Thorwegian/noaidi-fpga-synth/docs/adafruit_products_fab.png

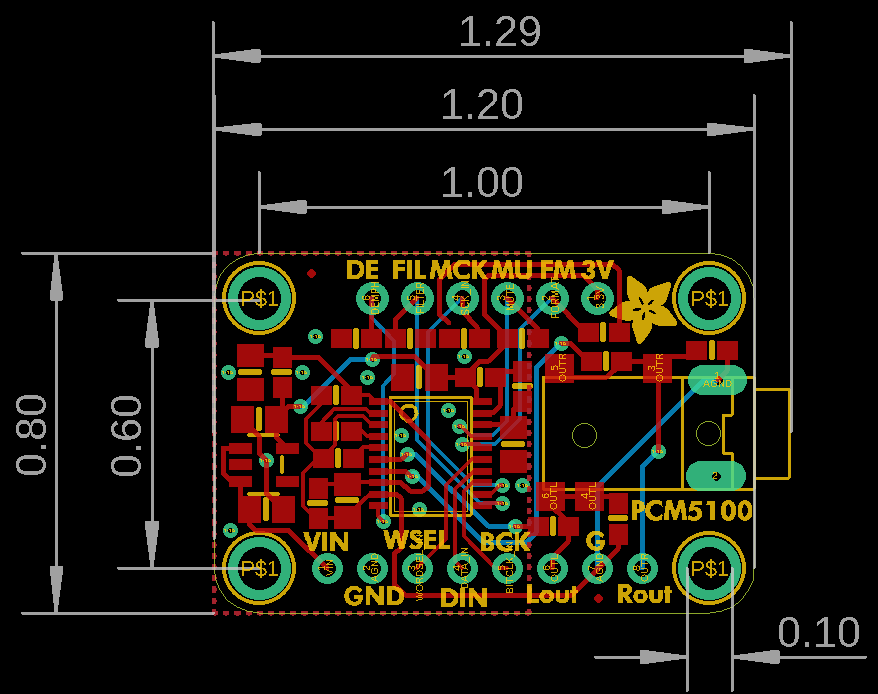
docs/adafruit_products_fab.png
