Thorwegian/noaidi-fpga-synth/docs/adafruit_products_schem.png

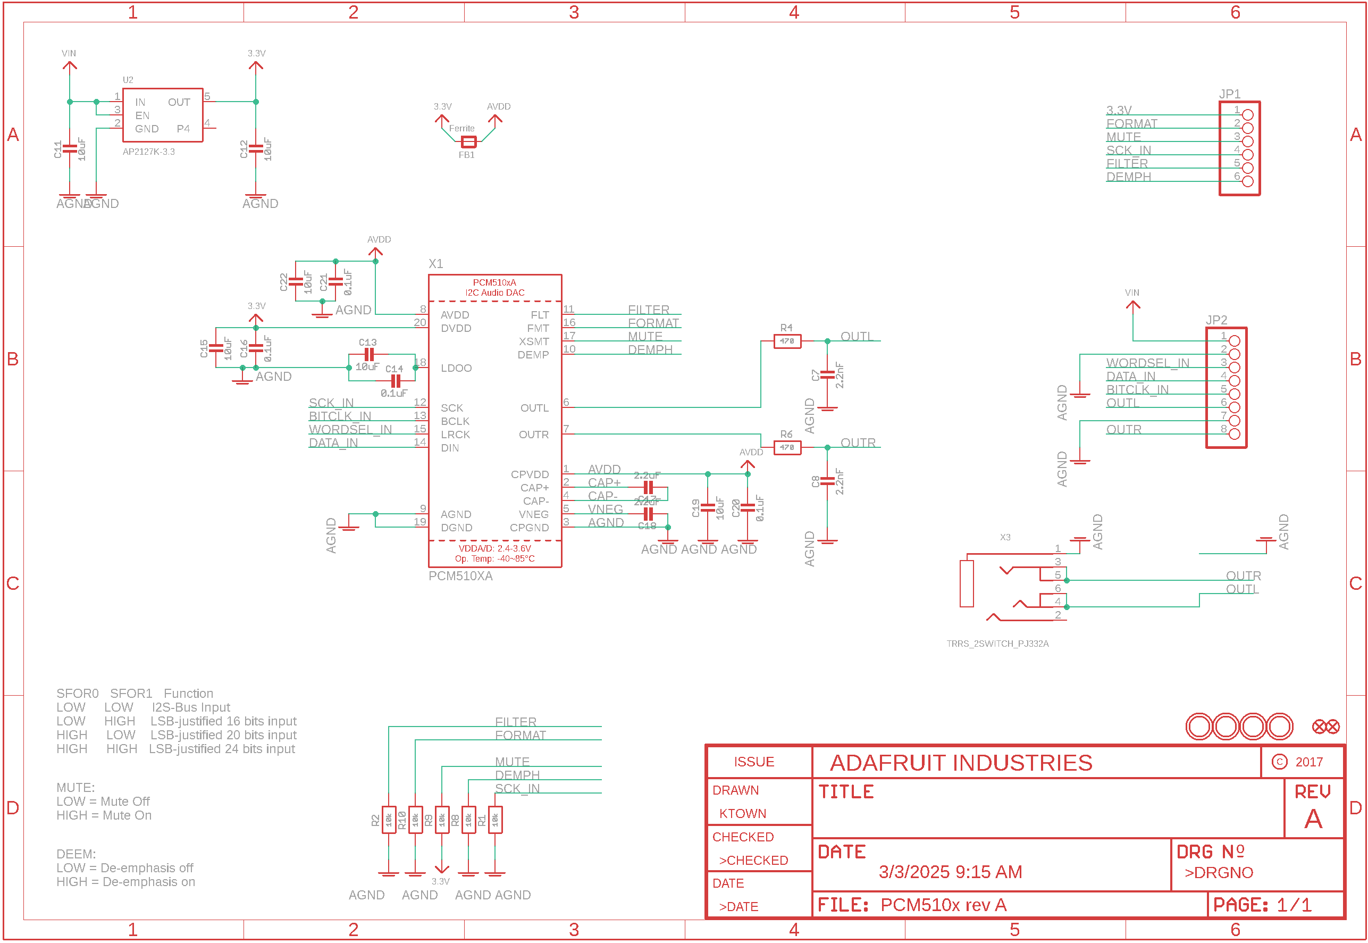
docs/adafruit_products_schem.png
