Thorwegian/noaidi-fpga-synth/docs/MIDI-circuit-6N138.png

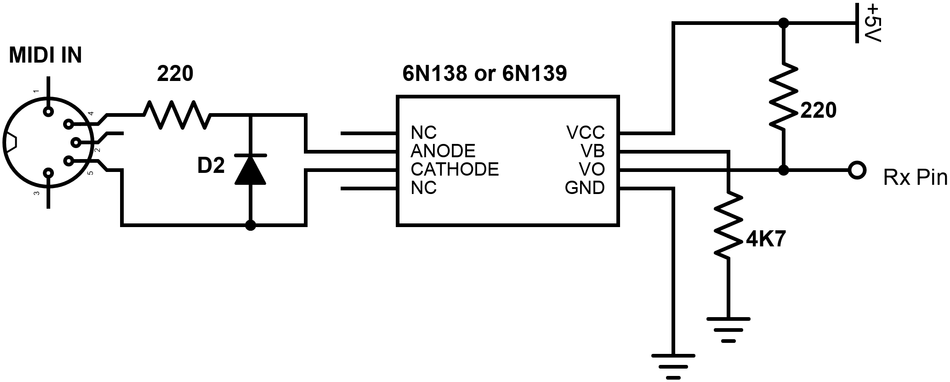
docs/MIDI-circuit-6N138.png
