Thorwegian/noaidi-fpga-synth/docs/Tang_Nano_20K_3921-Demensions.dxf

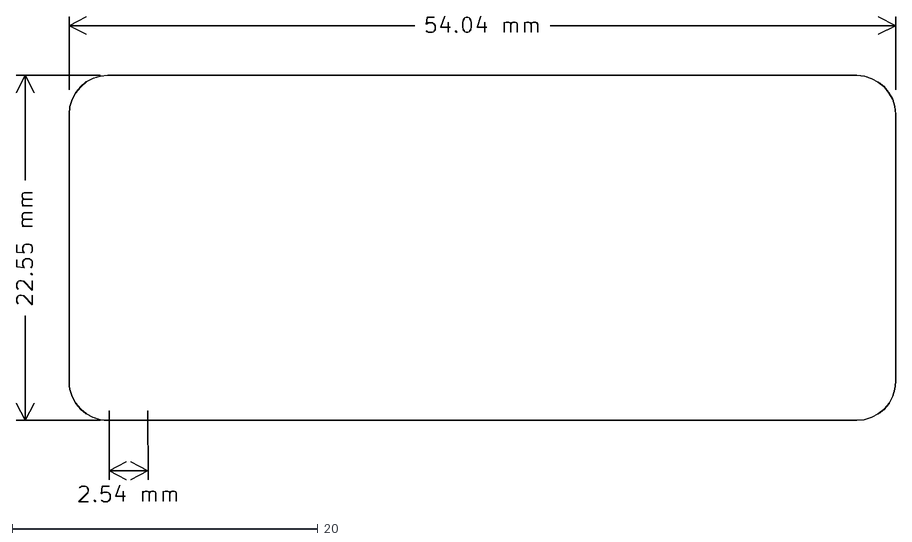
[picture p4: CAD file, 2026-09-15]
docs/Tang_Nano_20K_3921-Demensions.dxf
57.5 x 31.7
