Thorwegian/noaidi-fpga-synth/app/main/engine_link.c

// engine_link.c — command queue → parameter image → shadow writes → swap
//
// Copyright © 2026 Thor H. Linløkken <thj@thj.no>
// License: CERN-OHL-S v2

#include "engine_link.h"

#include <inttypes.h>
#include <string.h>

#include "esp_log.h"
#include "esp_rom_sys.h"
#include "esp_timer.h"
#include "freertos/FreeRTOS.h"
#include "freertos/queue.h"
#include "freertos/task.h"

#include "spi_regs.h"

#define TAG "engine_link"

#define ENGINE_QUEUE_LEN   1024   // voice_alloc's boot-time pointer
                                  // push alone is 512 commands
#define ENGINE_TASK_STACK  3072
#define ENGINE_TASK_PRIO   6          // above midi_log, below midi_in
// 1 kHz control rate (Thor). Paced by an esp_timer notifying the
// task, NOT vTaskDelayUntil: the FreeRTOS tick is 100 Hz, so a 1 ms
// delay would round to 0 ticks and assert.
#define ENGINE_TICK_US     1000

#define ELEM_BASE            0x2000
#define ELEM_STRIDE          64

// GAIN word with both channels at 0xFF = exact mute (0x00000000 is
// 0 dB full volume — the classic footgun).
#define P3_MUTE            0x0000FFFFu

static QueueHandle_t s_queue;
static QueueHandle_t s_bus_queue;
static uint32_t s_image[ENGINE_NUM_ELEMENTS][ENGINE_WORDS_PER_ELEMENT];

#define BUS_BASE_ADDR      0x0800
#define BUS_QUEUE_LEN      128    // init writes 32 envelope floors +
                                  // gates in one burst
#define PROD_BASE_ADDR     0x0100
#define PROD_QUEUE_LEN     512    // boot burst: 2 LFOs + 32 amp ADSRs
                                  // + 32 MOD envs (3 words each) + 32
                                  // fan-out sources (2 words) = 262
                                  // pushes before the 1 kHz tick can
                                  // drain. 256 silently dropped the
                                  // tail = voices 30/31's amp-env
                                  // configs = gain floor forever =
                                  // Thor's "every 32 note-ons it goes
                                  // low" (2026-09-10). Headroom 2x.

typedef struct {
    uint16_t bus;
    uint32_t value;
} bus_cmd_t;

typedef struct {
    uint8_t  entry;
    uint8_t  word;      // 0 CFG, 1 DEPTH
    uint32_t value;
} prod_cmd_t;

static QueueHandle_t s_prod_queue;
static uint32_t s_prod[ENGINE_NUM_PRODUCERS][3];
#define PDIRTY_WORDS (ENGINE_NUM_PRODUCERS * 3 / 32)
static uint32_t s_pdirty_now[PDIRTY_WORDS];
static uint32_t s_pdirty_prev[PDIRTY_WORDS];

// Dirty bitmaps, one bit per (elem, word): 1024 bits.
#define DIRTY_WORDS (ENGINE_NUM_ELEMENTS * ENGINE_WORDS_PER_ELEMENT / 32)
static uint32_t s_dirty_now[DIRTY_WORDS];   // changed since last swap
static uint32_t s_dirty_prev[DIRTY_WORDS];  // written before last swap

static uint32_t s_drops;

static inline void mark_dirty(int elem, int word)
{
    int bit = elem * ENGINE_WORDS_PER_ELEMENT + word;
    s_dirty_now[bit >> 5] |= 1u << (bit & 31);
}

// Write every image word to the current shadow bank. Boot-time only.
static void write_full_image(void)
{
    for (int e = 0; e < ENGINE_NUM_ELEMENTS; e++)
        fpga_word_write_burst(ELEM_BASE + e * ELEM_STRIDE, s_image[e],
                              ENGINE_WORDS_PER_ELEMENT);
}

static TaskHandle_t s_task;

static void tick_cb(void *arg)
{
    xTaskNotifyGive(s_task);   // runs in the esp_timer task
}

static void engine_task(void *arg)
{
    engine_cmd_t cmd;

    while (1) {
        ulTaskNotifyTake(pdTRUE, portMAX_DELAY);
        int64_t wake0 = esp_timer_get_time();

        // Live bus writes first: no banking, no swap — straight out.
        // No pacing needed: at 10 MHz one SPI word occupies the wire
        // for 5.6 us, longer than the mailbox's worst-case commit
        // wait (~3.6 us), so back-to-back writes cannot overrun the
        // 1-deep mailbox. (The stuck notes were a gateware
        // pending-clear bug, not an overrun.)
        bus_cmd_t bc;
        while (xQueueReceive(s_bus_queue, &bc, 0) == pdTRUE)
            fpga_word_write(BUS_BASE_ADDR + bc.bus, bc.value & 0x3FFFF);

        // Drain the queues into the images (elements + producers —
        // both banked, both covered by the same swap).
        bool changed = false;
        while (xQueueReceive(s_queue, &cmd, 0) == pdTRUE) {
            if (cmd.word >= ENGINE_WORDS_PER_ELEMENT)
                continue;   // elem is uint8_t: 0..255 by construction
            // No-op elision (Thor's Big-O/lazy principle, 2026-09-11):
            // the image IS the FPGA's state (the FPGA-reload → ESP-
            // reboot rule guarantees it), so a write of the value
            // already there is pure waste. voice_program re-renders
            // resend every word; skipping the unchanged ones turns a
            // one-knob re-render's flush from all 256 rows (~15 ms of
            // SPI — the wedge pressuring #97) into just the touched
            // rows.
            if (s_image[cmd.elem][cmd.word] == cmd.value)
                continue;
            s_image[cmd.elem][cmd.word] = cmd.value;
            mark_dirty(cmd.elem, cmd.word);
            changed = true;
        }
        prod_cmd_t pc;
        while (xQueueReceive(s_prod_queue, &pc, 0) == pdTRUE) {
            // entry is uint8_t = 0..255 — exactly the #100 pool, so
            // the old entry bound is vacuous (the type IS the bound)
            if (pc.word >= 3)
                continue;
            if (s_prod[pc.entry][pc.word] == pc.value)   // no-op elision
                continue;
            s_prod[pc.entry][pc.word] = pc.value;
            int bit = pc.entry * 3 + pc.word;
            s_pdirty_now[bit >> 5] |= 1u << (bit & 31);
            changed = true;
        }

        // Nothing new this tick and the shadow is already current
        // (nothing was written last tick either): skip write + swap.
        bool prev_any = false;
        for (int i = 0; i < DIRTY_WORDS; i++)
            if (s_dirty_prev[i]) { prev_any = true; break; }
        for (int i = 0; i < PDIRTY_WORDS; i++)
            if (s_pdirty_prev[i]) { prev_any = true; break; }
        if (!changed && !prev_any)
            continue;

        // Write dirty_now ∪ dirty_prev to the shadow, then swap. Burst
        // the WHOLE element row (7 consecutive words, one CS-framed
        // transaction) whenever any of its words changed. The ESP-IDF
        // SPI-master driver cost is per-TRANSACTION (bus lock, ISR,
        // semaphore), so the old per-word path turned a re-render into
        // hundreds of transactions and pinned this task until the
        // watchdog fired (#70). Untouched words in the row are already
        // current in s_image, so re-sending them is free.
        for (int e = 0; e < ENGINE_NUM_ELEMENTS; e++) {
            bool row_dirty = false;
            for (int w = 0; w < ENGINE_WORDS_PER_ELEMENT; w++) {
                int bit = e * ENGINE_WORDS_PER_ELEMENT + w;
                if ((s_dirty_now[bit >> 5] | s_dirty_prev[bit >> 5])
                        & (1u << (bit & 31))) {
                    row_dirty = true;
                    break;
                }
            }
            if (row_dirty)
                fpga_word_write_burst(ELEM_BASE + e * ELEM_STRIDE,
                                      s_image[e], ENGINE_WORDS_PER_ELEMENT);
        }
        for (int i = 0; i < PDIRTY_WORDS; i++) {
            uint32_t bits = s_pdirty_now[i] | s_pdirty_prev[i];
            while (bits) {
                int b = __builtin_ctz(bits);
                bits &= bits - 1;
                int idx = i * 32 + b;              // entry*3 + word
                fpga_word_write(PROD_BASE_ADDR + (idx / 3) * 4 + idx % 3,
                                s_prod[idx / 3][idx % 3]);
            }
        }
        fpga_swap();

        memcpy(s_dirty_prev, s_dirty_now, sizeof(s_dirty_prev));
        memset(s_dirty_now, 0, sizeof(s_dirty_now));
        memcpy(s_pdirty_prev, s_pdirty_now, sizeof(s_pdirty_prev));
        memset(s_pdirty_now, 0, sizeof(s_pdirty_now));

        // Drop visibility, always on (not just at init): a silent drop
        // is a voice configured wrong forever (2026-09-10, twice).
        static uint32_t s_drops_reported;
        if (s_drops != s_drops_reported) {
            ESP_LOGW(TAG, "engine writes dropped: %u total",
                     (unsigned)s_drops);
            s_drops_reported = s_drops;
        }

        if (s_drops) {
            ESP_LOGW(TAG, "queue full, dropped %" PRIu32 " commands", s_drops);
            s_drops = 0;
        }

        // Single-core guard (#70). If this wake ran long (a flood of
        // dirty rows to burst over SPI), the 1 kHz notify is already
        // pending, so the ulTaskNotifyTake above would return at once
        // and we would never block — starving IDLE (priority 0) on this
        // one-core chip → task watchdog. Yield a tick so IDLE runs; the
        // SPI image lags at most ~1 ms, which is inaudible.
        if (esp_timer_get_time() - wake0 > 800)
            vTaskDelay(1);
    }
}

void engine_link_init(void)
{
    // Image: every element gated off (and gain-muted for belt and
    // braces at boot), benign params otherwise. ALL pointers start on
    // bus 0 (the zero bus) — voice_alloc owns the plan and repoints
    // at note-on. (An earlier era parked cutoff pointers on bus 1 for
    // a hardwired wheel; the wheel rides BUS_CH_CUT since #44 and the
    // stale claim here was #110.)
    for (int e = 0; e < ENGINE_NUM_ELEMENTS; e++) {
        s_image[e][0] = 0;
        s_image[e][1] = 0;
        s_image[e][2] = 0x40000000;   // q1 = 1.0, fc = 0
        s_image[e][3] = P3_MUTE;
        s_image[e][4] = 0;            // GATE off
        s_image[e][5] = 0;            // PTRS0: all → bus 0 (none);
        s_image[e][6] = 0;            // PTRS1: voice_alloc owns the plan
    }

    // Both banks get the muted image before anything can play.
    write_full_image();
    fpga_swap();
    write_full_image();
    fpga_swap();
    ESP_LOGI(TAG, "both banks muted (%d elements)", ENGINE_NUM_ELEMENTS);

    s_queue = xQueueCreate(ENGINE_QUEUE_LEN, sizeof(engine_cmd_t));
    s_bus_queue = xQueueCreate(BUS_QUEUE_LEN, sizeof(bus_cmd_t));
    s_prod_queue = xQueueCreate(PROD_QUEUE_LEN, sizeof(prod_cmd_t));
    if (s_queue == NULL || s_bus_queue == NULL || s_prod_queue == NULL) {
        ESP_LOGE(TAG, "failed to create command queues");
        return;
    }

    if (xTaskCreate(engine_task, "engine_link", ENGINE_TASK_STACK, NULL,
                    ENGINE_TASK_PRIO, &s_task) != pdPASS) {
        ESP_LOGE(TAG, "failed to create task");
        return;
    }

    const esp_timer_create_args_t targs = {
        .callback = tick_cb, .name = "engine_tick",
    };
    esp_timer_handle_t timer;
    ESP_ERROR_CHECK(esp_timer_create(&targs, &timer));
    ESP_ERROR_CHECK(esp_timer_start_periodic(timer, ENGINE_TICK_US));
    ESP_LOGI(TAG, "1 kHz tick running");
}

bool engine_link_send(const engine_cmd_t *cmd)
{
    if (s_queue == NULL)
        return false;
    if (xQueueSend(s_queue, cmd, 0) != pdTRUE) {
        s_drops++;
        return false;
    }
    return true;
}

bool engine_link_bus_write(uint16_t bus, uint32_t value_q810)
{
    if (s_bus_queue == NULL || bus == 0 || bus >= 1024)
        return false;
    bus_cmd_t bc = {.bus = bus, .value = value_q810};
    if (xQueueSend(s_bus_queue, &bc, 0) != pdTRUE) {
        s_drops++;
        return false;
    }
    return true;
}

uint32_t engine_link_drops(void)
{
    return s_drops;
}

bool engine_link_prod_write(uint8_t entry, uint8_t word, uint32_t value)
{
    if (s_prod_queue == NULL || word >= 3)   // uint8_t entry spans the pool
        return false;
    prod_cmd_t pc = {.entry = entry, .word = word, .value = value};
    // Drops stay possible under a wedged flush (blocking here was
    // tried 2026-09-10 and reverted the same hour — risk containment
    // after a new symptom appeared with it live). The LOSSLESSNESS
    // guarantee lives one level up instead: voice_alloc's apply_dirty
    // checks engine_link_drops() around each config burst and RE-ARMS
    // the dirty bit when anything dropped, so the coalescer retries at
    // its own bounded pace until the config lands complete.
    if (xQueueSend(s_prod_queue, &pc, 0) != pdTRUE) {
        s_drops++;
        return false;
    }
    return true;
}
