Thorwegian/noaidi-fpga-synth/rtl/synth_pkg.sv

// synth_pkg.sv — shared design parameters
//
// Copyright © 2026 Thor H. Linløkken <thj@thj.no>
// License: CERN-OHL-S v2
//
// The single home for the design's constants (Thor: modules should
// not carry hardcoded numbers). Modules import what they need; module
// parameters default from here so testbenches can still override.

package synth_pkg;

    parameter int SAMPLE_RATE = 96000;
    // 768 x 96 kHz. Stepped down from 98.304 MHz (1024 slots) after
    // five ear-verified silicon timing failures that STA passed: the
    // fabric has no margin for our 36x36 DSP cascades at ~100 MHz,
    // and 25% more slack protects the paths we haven't found yet.
    parameter int SYS_CLK_HZ  = 73_728_000;

    //--- Drum (SCMO) scheduling -------------------------------------
    parameter int DRUM_CYCLES  = 768;    // SYS_CLK_HZ / SAMPLE_RATE
    parameter int DRUM_W       = 10;     // $clog2(DRUM_CYCLES)
    parameter int CELL_DIV     = 6;      // SPDIF cell = 6 sysclk (768 = 128 x 6)

    //--- Elements and lanes (design doc terminology) ----------------
    // The FPGA generates ELEMENTS (256 of them), technically via
    // LANES — time-multiplexed passes through the pipeline. The
    // ESP32 groups elements into voices; the FPGA never sees that.
    parameter int NUM_ELEMENTS = 256;
    parameter int ELEM_W       = 8;      // $clog2(NUM_ELEMENTS)
    parameter int UNISON       = 8;      // firmware convention only
    parameter int POLYPHONY    = 32;     // firmware convention only

    // Drum slot where element 0 enters the pipeline
    parameter int LANE_BASE    = 0;
    // Pipeline stages per element (S0..S11 + S3B/S5B/S8B/S9B splits)
    parameter int LANE_STAGES  = 16;
    // Contiguous drum span occupied by the lane pipeline
    parameter int LANE_SPAN    = NUM_ELEMENTS + LANE_STAGES - 1;

    // Drum slot where a pending ping-pong bank swap executes: the
    // pipeline is drained there (LANE_SPAN < SWAP_SLOT), so every
    // sample reads one consistent bank generation.
    parameter int SWAP_SLOT    = 512;

    //--- SPI memory map (docs/memory_map.md) ------------------------
    parameter int          MAP_AW_BACKED   = 11;       // 2048-word window
    parameter logic [7:0]  SPI_ID_BYTE     = 8'hA5;
    parameter logic [15:0] MAP_CTRL_ADDR   = 16'h0002; // bit 0: swap request
    parameter logic [15:0] MAP_ELEM_BASE   = 16'h2000; // per-element params
    parameter int          MAP_ELEM_STRIDE = 64;       // words per element

    //--- Bus fabric (docs/bus_architecture.md) ----------------------
    parameter logic [15:0] MAP_BUS_BASE = 16'h0800;    // bus base registers
    parameter int          DMEM_WORDS    = 512;         // uniform pool (#134)
    parameter int          BUS_W        = 18;          // signed Q8.10

    //--- Instruction table (B4/B5) -------------------------------------
    // 128 entries x 3 words, stride 4, at 0x0100-0x02FF. Config is
    // wiring, so it rides the ping-pong banks (law 4).
    //   +0 CFG:   [3:0] type (0 off, 1 LFO, 2 ADSR), [5:4] LFO shape
    //             (osc_core: saw/pulse/tri/sine), [15:6] target bus,
    //             LFO: [31:16] rate (low 16 bits of the UQ0.24 phase
    //                  increment — 5.7 mHz steps, 375 Hz max)
    //             ADSR: [25:16] gate bus (watched, level-sensitive:
    //                   value > 0 = held)
    //   +1 RATES (ADSR): [7:0] attack, [15:8] decay, [23:16] SUSTAIN
    //             (level fraction, 8 bits), [31:24] RELEASE — byte
    //             order matches patch_adsr_word(), the pipeline
    //             decode and memory_map.md (a swapped S/R in this
    //             comment was issue #105). Rates are 8-bit log2:
    //             increment = (16+frac) << oct on the 22-bit level
    //   +2 DEPTH: [17:0] signed Q8.10 contribution amplitude
    // A instruction's OUTPUT uses the previous sample's state (the
    // one-sample lag keeps every multiply's operands registered).
    // Pool 256, FULL RATE (#145): the CSP retires one instruction per
    // cycle, so all 256 entries execute every sample — 256 of the
    // sample's 768 cycles — and every source updates at 96 kHz. This
    // replaces the half-rate sequencer (#100, Thor 2026-09-11), which
    // walked alternate halves for 48 kHz effective because an
    // instruction then cost three cycles. Its allocator rule — a chain
    // (sources + their sends sharing a target) must live within ONE
    // half — is retired with it; a chain now tolerates gaps of up to
    // three slots, the depth of the accumulator's forwarding history.
    // Region 0x0100..0x04FF (stride 4). INSTR_PER_PASS is gone: a pass
    // is the whole table.
    parameter logic [15:0] MAP_IMEM_BASE = 16'h0100;
    parameter int          NUM_INSTR = 256;

    // CSP opcode = a bitmask of enables (#145), not an enum. Each bit turns
    // on one part of the datapath, so decode is enables rather than a mux
    // tree and a new instruction is an encoding rather than a new case.
    parameter int OPC_SOURCE = 0;   // reads a source operand (SEND, ADSR gate)
    parameter int OPC_STATE  = 1;   // has persistent state (LFO, ADSR)
    parameter int OPC_MUL    = 2;   // multiplies the operand by DEPTH
    parameter int OPC_ACCUM  = 3;   // accumulates onto the target, vs load init
    // An envelope is the instruction that watches a gate, so STATE+SOURCE
    // means envelope and STATE alone means phase accumulator -- no fifth bit
    // is needed and the opcode still fits CFG[3:0].
    parameter logic [3:0] OPC_OFF  = 4'h0;
    parameter logic [3:0] OPC_LFO  = 4'hE;  // state + mul + accum
    parameter logic [3:0] OPC_ADSR = 4'hF;  // source + state + mul + accum
    parameter logic [3:0] OPC_SEND = 4'hD;  // source + mul + accum

    //--- Filter stability clamp (Thor's call, 2026-08-31) ------------
    // Instability comes from HEAVY DAMPING (low Q = high q1), not
    // from resonance — theory and the autocorrelation bench agree.
    //
    //   FC_MAX = 0x2B20 = 14.4 kHz (Thor's pick): one measured-clean
    //   step of margin below the resonance bloom that precedes the
    //   16 kHz wall. Measured at q1 = sqrt(2), the heaviest damping
    //   any resonance code decodes to: clean through 15.7 kHz,
    //   limit-cycles at 16.4 kHz, chaos at 19.5 kHz.
    //
    // The old Q1_MAX = sqrt(2) clamp is retired (2026-09-02): with
    // log2-encoded resonance (r octaves of Q above Butterworth,
    // q1 = sqrt2 * 2^-r via q1_lut), r = 0 IS Butterworth and no
    // code decodes heavier — the clamp became structural. The high-Q
    // end stays open by design: at the top of the range the decode
    // underflows q1 to zero — self-oscillation as a feature.
    parameter logic [13:0] FC_MAX = 14'h2B20;

    //--- Number formats (design doc) ---------------------------------
    parameter int OSC_W = 24;       // UQ0.24 phase accumulator
    typedef logic signed [OSC_W-1:0] osc_t;

    parameter int CTRL_W = 14;      // UQ4.10 pitch/cutoff

    parameter int AUDIO_W = 18;     // Q4.14 audio transport (#63)
    typedef logic signed [AUDIO_W-1:0] sample_t;

    parameter int SVF_W = 36;       // Q8.28 filter states

    parameter int AUDIO_SHIFT = 14;

endpackage
