Thorwegian/noaidi-fpga-synth/app/main/patch.c

// patch.c — the active-patch instance and its default (issue #69).
//
// Copyright © 2026 Thor H. Linløkken <thj@thj.no>
// License: CERN-OHL-S v2
//
// Foundation of the VA surface: g_patch is the single source of
// truth for the active sound. patch_default() reproduces the former
// hardcoded timbre EXACTLY, so wiring voice_alloc to render from it
// is behavior-identical (verify: sounds the same). Later issues move
// more constants into the struct and add CC/SysEx mutation.

#include "patch.h"
#include <string.h>

patch_t g_patch;

// Pack an ADSR into the source-table RATES word (A | D<<8 | S<<16 |
// R<<24) — the gateware's universal A,D,S,R byte order.
//
// HALF-RATE COMPENSATION (#100): the walker advances each envelope
// every OTHER sample now (48 kHz effective), which alone would double
// every attack/decay/release time. The rate decode is
// (16+low4) << high4, so adding 1 to the exponent nibble (+0x10 on
// the byte) doubles the increment and restores wall-clock times
// exactly. Saturating: the 16 fastest codes flatten onto the ceiling
// (already sub-millisecond). Sustain is a LEVEL — untouched.
uint32_t patch_adsr_word(const adsr_t *e)
{
    uint32_t a = e->attack  > 0xEF ? 0xFF : (uint32_t)e->attack  + 0x10;
    uint32_t d = e->decay   > 0xEF ? 0xFF : (uint32_t)e->decay   + 0x10;
    uint32_t r = e->release > 0xEF ? 0xFF : (uint32_t)e->release + 0x10;
    return a | (d << 8) | ((uint32_t)e->sustain << 16) | (r << 24);
}

void patch_default(patch_t *p)
{
    memset(p, 0, sizeof(*p));

    // ---- oscillators (both rendered now, issue #72) ----
    // Default voice (Thor, 2026-09-08): the "7+1" structure — a
    // 7-voice supersaw (osc1) plus a single pure sine (osc2) one
    // octave below. The sine sub fattens the saws without muddying
    // the midrange; the ×7 detune gives the classic supersaw width.
    p->osc[0].wave   = WAVE_SAW;    // the ×7 supersaw
    p->osc[1].wave   = WAVE_SINE;   // the single "+1" — a pure sine
    p->osc[1].coarse = -12;         // one octave below the supersaw (sub)
    p->voice_struct  = VOICE_7_PLUS_1;
    p->osc_mix       = 0;      // centre balance
    p->unison_detune = 6;      // LSB per spread step (supersaw spread)
    p->unison_stereo = 127;    // full stereo spread = the historical
                               // hard pan (CC 28 continuous since #98)

    p->vel_amp_sens = 64;              // = historical (127-vel)>>1 feel
    p->vel_cut_sens = 64;              // = historical vel*48 brightening

    p->filter.key_track = 64;          // center = 100% tracking = the
                                       // historical voice_fc behavior
                                       // (#91; 0..200% scale since #94)
    p->filter.resonance = 0x200;       // was RESO (q1 = 1.0)
    p->filter.type      = 0;           // LP
    p->filter.dual      = 1;           // 24 dB/oct default (Thor, 2026-09-08)

    // amp env — was ADSR_RATES (0x98/0x20/0xF0/0x28, A,D,S,R)
    p->env[0].attack  = 0x98;
    p->env[0].decay   = 0x20;
    p->env[0].sustain = 0xF0;
    p->env[0].release = 0x28;

    // MOD env (#87, Thor 2026-09-09): ON by default in the boot patch —
    // same initial params as the AMP envelope, sent to the cutoff bus.
    // The filter contour tracks the loudness contour: opens with the
    // attack, settles bright at sustain, closes on release.
    p->env[1] = p->env[0];
    p->env1_dest      = 0;             // cutoff (the only dest yet)
    p->env1_depth     = 2048;          // +2 octaves send (CC 107 ≈ 96)

    // LFO 1 = the boot vibrato (source 0): 1 Hz triangle, ±19 cents
    p->lfo[0].shape = 2;               // triangle
    p->lfo[0].rate  = 350;             // ~1 Hz (increment per 48 kHz
                                       // walk since #100 — was 175
                                       // at the 96 kHz walk)
    p->lfo[0].depth = 16;

    // LFO 2 (#73, source 1): triangle, ~1 Hz, depth 0 = OFF; default
    // destination is PWM (duty bus) — the thing LFO 1 can't do.
    p->lfo[1].shape = 2;
    p->lfo[1].rate  = 350;             // ~1 Hz at the 48 kHz walk (#100)
    p->lfo[1].depth = 0;
    p->lfo[1].dest  = 0;               // 0 duty (PWM), 1 resonance.
                                       // (pitch is LFO 1's bus — one
                                       // producer per bus in the walker)

    p->volume     = 0xCF;              // was VOL_BASE (~-18 dB as volume)
    p->bend_range = 2;                 // current ±2 semitones
}
