Thorwegian/noaidi-fpga-synth/rtl/tb/tb_osc_core.sv

// Copyright © 2026 Thor H. Linløkken <thj@thj.no>
// License: CERN-OHL-S v2
//
//--------------------------------------------------------------------
// tb_osc_core.sv — oscillator waveform bench (was missing; issue #70
// ear reports: wave 3 "noisy tone", pulse duty "does nothing"). Drives
// a phase accumulator into osc_core the way the pipeline does
// (phase_next = phase + delta, now added in the bench since #128 moved
// that adder out of the module) and asserts the SHAPE of each waveform,
// plus that the pulse high-fraction tracks duty. Proves osc_core is
// functionally correct in isolation — so a hardware fault is upstream
// (bus/pointer plumbing or synthesis), not in the core math.
//--------------------------------------------------------------------
`default_nettype none
`timescale 1ns/1ps

module tb_osc_core;
    logic signed [23:0] phase, delta, duty;
    logic        [1:0]  wave;
    logic signed [17:0] sample_out;

    // #128 moved the phase adder OUT of osc_core (it was duplicated by
    // element_pipeline, and having it inside forced BSRAM read -> shift
    // -> add -> sine LUT -> mux into one cycle). The bench now performs
    // the same add the pipeline does, so every check below is unchanged:
    // phase_next is still phase + delta exactly as before.
    wire signed [23:0] phase_next = phase + delta;

    osc_core dut (
        .phase_next (phase_next), .duty (duty), .wave (wave),
        .sample_out (sample_out)
    );

    localparam int N = 64;                       // samples per cycle
    localparam signed [23:0] DELTA = 24'sh040000; // 2^24 / 64
    integer errors = 0;

    // Count how many of one cycle's samples are positive (high).
    task automatic high_count(input [1:0] w, input signed [23:0] d,
                              output integer hi);
        integer i;
        begin
            wave = w; duty = d; phase = 24'sd0; hi = 0;
            for (i = 0; i < N; i = i + 1) begin
                #1;
                if (sample_out > 0) hi = hi + 1;
                phase = phase + DELTA;
            end
        end
    endtask

    // One sample at an exact phase (delta 0 so phase_next == phase).
    task automatic sample_at(input [1:0] w, input signed [23:0] p,
                             output integer s);
        begin
            wave = w; duty = 24'sd0; delta = 24'sd0; phase = p;
            #1;
            s = sample_out;
            delta = DELTA;
        end
    endtask

    // Peak magnitude over one cycle.
    task automatic peak_mag(input [1:0] w, output integer pk);
        integer i, a;
        begin
            wave = w; duty = 24'sd0; phase = 24'sd0; pk = 0;
            for (i = 0; i < N; i = i + 1) begin
                #1;
                a = (sample_out < 0) ? -sample_out : sample_out;
                if (a > pk) pk = a;
                phase = phase + DELTA;
            end
        end
    endtask

    task check(input cond, input [255:0] msg);
        begin
            if (!cond) begin $display("FAIL: %0s", msg); errors = errors + 1; end
            else         $display("ok:   %0s", msg);
        end
    endtask

    integer h_lo, h_mid, h_hi, pk_saw, pk_sine;
    integer s_q0, s_q1, s_q2, s_q3;
    initial begin
        delta = DELTA;

        // SAW and the LUT SINE both reach near full-scale.
        peak_mag(2'd0, pk_saw);
        peak_mag(2'd3, pk_sine);
        check(pk_saw  > 30000, "saw reaches near full scale");
        check(pk_sine > 30000, "sine reaches near full scale (LUT)");

        // Sine cardinal points: 0 at phase 0, +peak at 1/4, 0 at 1/2,
        // -peak at 3/4 (a true sine, not the old parabola).
        sample_at(2'd3, 24'h000000, s_q0);
        sample_at(2'd3, 24'h400000, s_q1);
        sample_at(2'd3, 24'h800000, s_q2);
        sample_at(2'd3, 24'hC00000, s_q3);
        $display("sine cardinals: 0=%0d q=%0d h=%0d 3q=%0d", s_q0, s_q1, s_q2, s_q3);
        check(s_q0 > -600 && s_q0 < 600, "sine(0)   ~ 0");
        check(s_q1 > 30000,              "sine(1/4) ~ +peak");
        check(s_q2 > -600 && s_q2 < 600, "sine(1/2) ~ 0");
        check(s_q3 < -30000,             "sine(3/4) ~ -peak");

        // Pulse high-fraction must RISE with duty (the CC 25 sweep).
        high_count(2'd1, -24'sh600000, h_lo);
        high_count(2'd1,  24'sd0,      h_mid);
        high_count(2'd1,  24'sh600000, h_hi);
        $display("pulse high-count: lo=%0d mid=%0d hi=%0d (of %0d)", h_lo, h_mid, h_hi, N);
        check(h_lo < h_mid,  "pulse duty low  < mid  (width tracks duty)");
        check(h_mid < h_hi,  "pulse duty mid  < high (width tracks duty)");
        check(h_mid >= N/2-2 && h_mid <= N/2+2, "pulse at duty 0 is ~50%");

        // "ALL PASS" is the suite-wide success marker ci_bench.sh
        // greps for (this bench read "RESULT ...: PASS", which the
        // harness did not recognize once sim-osc joined CI in #107).
        if (errors == 0) $display("RESULT tb_osc_core: ALL PASS");
        else             $display("RESULT tb_osc_core: FAIL (%0d)", errors);
        $finish;
    end
endmodule
`default_nettype wire
