Thorwegian/noaidi-fpga-synth/app/main/midi_log.h

// midi_log.h — console monitor task for MIDI events
//
// Copyright © 2026 Thor H. Linløkken <thj@thj.no>
// License: CERN-OHL-S v2
//
// Subscribes to the event bus with its own queue and decodes/prints
// MIDI messages from its own task. This keeps blocking printf() out
// of the MIDI RX path.

#pragma once

#ifdef __cplusplus
extern "C" {
#endif

// Call once at boot (after event_bus_init).
void midi_log_init(void);

#ifdef __cplusplus
}
#endif
