Thorwegian/noaidi-fpga-synth/app/main/midi_parser.c

// midi_parser.c — MIDI byte-stream parser (pure, hardware-independent)
//
// Copyright © 2026 Thor H. Linløkken <thj@thj.no>
// License: CERN-OHL-S v2
//
// See midi_parser.h for the protocol behaviour. This module has no
// hardware dependencies and no heap usage — it can later be reused
// unchanged for other MIDI transports (USB MIDI, BLE MIDI, ...).

#include "midi_parser.h"

void midi_parser_init(midi_parser_t *p, midi_msg_cb_t cb, void *user)
{
    p->on_message = cb;
    p->user = user;
    midi_parser_reset(p);
}

void midi_parser_reset_partial(midi_parser_t *p)
{
    p->data_count = 0;
    p->in_sysex = false;
}

void midi_parser_reset(midi_parser_t *p)
{
    p->running_status = 0;
    p->data_count = 0;
    p->data_len = 0;
    p->in_sysex = false;
}

void midi_parser_feed(midi_parser_t *p, uint8_t byte)
{
    // ── System Real-Time (F8..FF) ──────────────────────────────────
    // May appear anywhere, including between the bytes of a running
    // message or inside SysEx. Ignored; never touch parser state.
    // FF (System Reset) additionally cancels Running Status.
    if (byte >= 0xF8) {
        if (byte == 0xFF) {
            p->running_status = 0;
            p->data_count = 0;
        }
        return;
    }

    // ── System Common (F0..F7) ─────────────────────────────────────
    // All of these cancel Running Status. SysEx payload is dropped
    // until the terminating F7.
    if (byte >= 0xF0) {
        if (byte == 0xF0) {
            p->in_sysex = true;
        } else if (byte == 0xF7) {
            p->in_sysex = false;
        }
        p->running_status = 0;
        p->data_count = 0;
        return;
    }

    // ── SysEx payload ──────────────────────────────────────────────
    if (p->in_sysex) {
        return; // drop everything until F7
    }
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
