Thorwegian/noaidi-fpga-synth/(commit log)

2026-07-06 feat: I2S clock generator + MS5351 pin constraints
2026-07-06 feat: wire I2S TX, SSPI-as-GPIO, audio path in top.v
2026-07-06 feat: voice pipeline — phase accumulator + naive sawtooth
2026-07-06 feat: NEORV32 firmware — UART1 MIDI + console commands
2026-07-06 docs: README with pinout, architecture, build flow
2026-07-06 docs: fix README — no PolyBLEP, MS5351 clock, 96 kHz, current status
2026-07-06 feat: Milestone 2 — bilinear SVF lowpass, 500 Hz Q=1.0, hw-verified
    - svf.sv: Lazzarini-Timoney bilinear SVF, combinational datapath
    - Q3.14 audio (18-bit), Q0.24 K (24-bit), all single-DSP multiplies
    - phase_accumulator: Q0.24, 24-bit, 440 Hz f_word=76896
    - osc_bank: full-scale saw, Q3.14 output
    - top.sv: SVF wired between osc and I2S
    - All .v files renamed to .sv
    - main.c: NEORV32 API fixes (getc, printf)
    - README: updated feature list, build commands
    - build.tcl: svf.sv enabled
    [i2s_tx.sv, main.c, top.sv]
2026-07-06 svf: working sweep with DSP-annotated bilinear SVF
    - svf.sv: bilinear SVF, Q3.14/Q0.24, 25-bit K_s padding, combinational
    path with DSP annotations on all 4 multiplies (7.5/24 DSPs used)
    - k_sweep.sv: LUT-based coefficient sweep module (320 entries, loops)
    - k_lut.hex: precomputed K/inv_res_K/inv_div table (18-18432 Hz, Q=6)
    - top.sv: wire k_sweep → SVF, K from LUT, coeffs from LUT
    - build.tcl: add k_sweep.sv, remove polyblep refs
    - README.md: remove polyblep refs
2026-07-07 feat: K LUT and coefficient computer modules
    k_lut.sv — 2560-entry K LUT with linear interpolation.
    256 entries/octave, 10 octaves (18 Hz – 18.4 kHz).
    Linear interp: 0.08 cents worst-case error.
    7.5 KB / ~4 BRAM blocks.
    coeff_computer.sv — top-level coefficient computer.
    Ties K LUT + DSP multiplies + denominator sum +
    NR reciprocal + inv_res_K adder together.
    ~12-cycle pipeline latency, ready for TDM integration.
    2 DSP multipliers for K² and K/Q.
    Related: #7 (TDM sequencer), #12 (coefficient engine)
2026-07-07 feat: combine K+K² in packed-struct LUT, remove k_sweep
    k_lut.sv now uses SystemVerilog packed struct:
    typedef struct packed {logic[17:0] K2; logic[23:0] K;} k_entry_t;
    2560 entries × 42 bits = 13.4 KB (~6 BRAM blocks).
    Precomputed K² saves 1 DSP per voice sample.
    coeff_computer.sv: reads K² from LUT instead of DSP compute.
    DSP count drops from 2 to 1 (K/Q only).
    Removed k_sweep.sv — replaced by coeff_computer pipeline.
    Verified: 120 vectors, 0 errors end-to-end in iverilog.
    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
2026-07-07 fix: anchor K LUT at MIDI D0 (note 14, 18.35 Hz)
    cent=0 → D0 (18.35 Hz), nearest musical note to 18 Hz.
    Maps cleanly: cents = (midi_note - 14) × 100.
    10.0 octaves, D0–D10 (MIDI 14–134, 18–18795 Hz).
    Also fixes gen_k_lut.py top-note display.
2026-07-07 docs: rewrite scripts with Java SDK-quality clarity
    gen_k_lut.py:
    - Structured: constants → LUT generation → verification → report
    - All constants named and documented with rationale
    - Clear variable names (frequency_hz, K_exact, entry_index)
    - Function docstrings explain what, why, and the RTL mapping
    coeff_computer_proto.py:
    - Full pipeline model: K LUT → DSP → NR reciprocal
    - 5 distinct tests with named sections
    - Consistent formatting, clear error metric explanation
    gen_nr_testvecs.py:
    - Merged functionality from gen_reciprocal_verify.py (removed)
    - Bit-exact RTL model with same LUT indexing as nr_reciprocal.sv
    All scripts verified: produce identical output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
2026-07-07 feat: wire coeff_computer into top.sv with 1-second sweep
    top.sv:
    - Replaced k_sweep with coeff_computer
    - Added 32-bit phase accumulator sweep: D0→D10 in ~1 sec
    - Sweep step = 1748 per sample (655360 units / 96000 samples)
    - SVF strobed by coeff_computer valid_out (not raw sample_strobe)
    - Q=6.0 hardcoded for testing (one_over_Q=2730)
    Stability verified in iverilog across D0–D10 (18 Hz – 18.8 kHz).
    Filter states stay bounded, no saturation at extremes.
    Related: #7 (TDM), #12 (coeff engine)
    [tb_svf_stability.sv, top.sv]
2026-07-07 refactor: gate NEORV32 with ifndef IVERILOG for iverilog testing
    top.sv now compiles standalone in iverilog (iverilog -DIVERILOG).
    NEORV32 is included for Gowin synthesis, stubbed for simulation.
    UART TX and LEDs get safe inactive values in test mode.
    Unblocks end-to-end iverilog testing of the full audio pipeline
    (clock → osc → coeff_computer → SVF → I2S).
2026-07-07 fix: drop sweep Q from 6 to 1 (filter saturating at high Q)
    Iverilog sweep simulation showed saturation at ±26k–±36k
    with Q=6 across the full frequency range. At Q=1, only
    marginal values within audio range (±15563, ±15923).
    The bilinear SVF with quantized coefficients is not stable
    at Q=6 across all K values. Q=1 matches the original sweep
    LUT setting.
    [top.sv]
2026-07-07 fix: AND sample_strobe with cc_valid for SVF timing
    cc_valid fires ~13 cycles after sample_strobe, which misaligns
    the DSP pipeline registers. SVF now gates on sample_strobe & cc_valid,
    keeping original I2S-synchronized timing.
    [top.sv]
2026-07-07 fix: use cc_valid rising-edge detect for SVF strobe
    sample_strobe & cc_valid never fires (both 1-cycle pulses at
    different times). Rising-edge detect on cc_valid gives a clean
    single-cycle strobe aligned with coefficient-ready.
    [top.sv]
2026-07-07 fix: reset sweep phase at end of range (was wrapping every 25.6s)
    32-bit accumulator wraps at 2^32/1748/96k = 25.6s. The actual
    sweep covers 1s, with 24.5s of saturation between wraps.
    Now resets at ~655200 cents (near end of 10-octave range).
    [top.sv]
2026-07-07 fix: revert SVF strobe to sample_strobe (pipeline has 1024 cycles headroom)
    [top.sv]
2026-07-07 feat: cross-instance Hermes status file for Mac ↔ Linux coordination
2026-07-07 feat: pulse oscillator, waveform mux in osc_bank
    osc_bank.sv now supports saw (000) and pulse (001).
    Pulse: phase < pwm_width → +1.0, else −1.0.
    pwm_width Q0.16, default 32768 = 50% duty.
    Fixed-point comparison matches Q0.24 phase format.
    Waveform mux: case statement, saw default.
    Ready for #1 pulse/triangle/supersaw waveforms.
    [top.sv]
2026-07-07 test: switch to pulse waveform for hardware test
2026-07-07 osc: triangle waveform from pulse integration
    - osc_bank.sv: triangle (010) — 27-bit signed integrator, pulse in, tri out
    - tb_osc_bank.sv: pass/fail testbench for saw/pulse/triangle
    - README.md: pulse marked done, triangle added to checklist
2026-07-09 osc: normalised triangle, Gowin fixes, sine implementation
    - osc_bank: freq_word port, normalised tri_step=sign(pulse)×freq_word
    (frequency-independent amplitude). Explicit tri_en latch to fix
    Gowin DFFE inference (strips single-cycle if(strobe) gate).
    - osc_bank: sine waveform (011), integrates triangle
    - top.sv: registered audio_sample to fix Gowin <<<4 bit-map
    mangling. WAVE_TRI/WAVE_SIN localparams. SVF bypass for debug.
    - Makefile: 'make silence' target for instant quiet
    - iverilog-verified: triangle at full scale across frequencies
    - Hardware-verified: triangle audible at 500 Hz
    [top.sv]
2026-07-09 repo: restructure to noaidi-fpga-synth root, extract neorv32
    - Move .git to noaidi-fpga-synth/ (repo name = git root)
    - Flatten rtl/rtl/ -> rtl/
    - Move sw/ and scripts/ to root level
    - Extract neorv32/ to /home/thor/Documents/Code/neorv32 (own repo)
    - Remove .hermes/ and HERMES_STATUS.md from repo
    - Fix .gitignore paths
    [top.sv]
2026-07-09 sine: in progress — Gowin synthesis bug in sin_acc path
    - Triangle: bipolar, normalised, hardware-verified at 1 kHz
    - Sine: simple integrator produces clean waveform in iverilog
    but silent/beeps in hardware (Gowin synthesis issue)
    - NEORV32 disabled, SVF disabled for faster osc dev cycle
    - Sine oscillator shelved for now — needs fresh debugging
    [top.sv]
2026-07-09 osc_bank: reset to blank slate — stateless phase-driven architecture
    Parallel waveform outputs (saw/pulse/triangle/sine), no internal state,
    no waveform select mux. Phase and duty are Q0.24 signed, allowing direct
    LFO modulation of pulse width. Implementation plan in osc_bank.md:
    saw=passthrough, pulse=comparator, triangle=abs()+shift, sine=¼-wave LUT.
    This is the architectural baseline — all previous self-oscillating
    integrator approaches are retired.
2026-07-09 osc_bank: stateless phase-driven implementation — hardware-verified
    osc_bank.sv — pure combinational waveforms:
    - Saw: phase passthrough
    - Pulse: signed comparator (phase < duty), verified at 0/33/50/66/100%
    - Triangle: fold at 2^23 midpoint, 2's-complement wrapping, no 25-bit
    - Sine: placeholder (zero)
    phase_accumulator.sv — standalone 24-bit Q0.24 accumulator, no reset
    top.sv — updated for new osc_bank parallel outputs (saw/pul/tri/sin),
    removed WAVE_* localparams, Q0.24 → I2S via >>> 4 (−24 dBFS)
    top_silence.sv + build_silence.tcl — minimal 'dead' bitstream,
    all outputs tied to idle, synthesises in ~10 seconds
    tb_osc_bank.sv — boundary verification: triangl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
    [top.sv]
2026-07-09 osc_bank: sine — ¼-wave LUT with quadrant decoding, hardware-verified
    4096×14-bit LUT covering [0, π/2]. Quadrant decode:
    phase[23:22] → quadrant, phase[21:10] → address
    Odd quadrants mirror address, Q2/Q3 negate output.
    Output: {raw, 10'd0} → Q0.24 signed, peak at 8191<<10.
    LUT generated by scripts/gen_sine_lut.py, stored as sine_lut.hex.
    Currently mapped to distributed RAM (3,475 LUTs) — BRAM inference
    to be forced later.
    All four waveforms now implemented and hardware-verified at 1 kHz
    on Tang Nano 20K: saw, pulse (0–100% duty), triangle, sine.
2026-07-09 SVF: re-verified with stateless osc_bank, Q=1 and Q=6 both stable
    Q0.24→Q3.14 conversion: $signed(osc_saw) >>> 9 (both saw and
    triangle are already bipolar — no centering needed).
    SVF output scaling: $signed({svf_out}) <<< 6 = −18 dBFS
    (matches working commit 3fd1b5f).
    Hardware-verified at 500 Hz, Q=1.0 and Q=6.0 on 440 Hz sawtooth:
    - Q=1: clean lowpass, no saturation
    - Q=6: strong resonant peak at cutoff, stable (±8k in Q3.14)
    - iverilog sim confirms both within ±16k bounds
    coeff_computer pipeline removed for now — timing issue between
    cc_valid and SVF strobe to be addressed separately.
    [top.sv]
2026-07-09 coeff_computer: removed — SVF verified stable at all K with static coeffs
    Oscillator bank + bilinear SVF hardware-verified on Tang Nano 20K:
    - Q=1: stable from 500 Hz to 18 kHz cutoff (static coefficients)
    - Q=6: stable at 500 Hz with resonant peak confirmed audible
    - All four osc waveforms (saw/pulse/tri/sine) working correctly
    coeff_computer pipeline removed — cc_valid strobe timing caused
    crackling at high K during sweeps. Individual modules (k_lut,
    nr_reciprocal, coeff_computer) passed iverilog but never reliably
    integrated with SVF in hardware.
    Deleted 12 files: coeff_computer pipeline modules, LUTs, testbenches,
    and Python generators. Future approach: precomputed BRAM LUT f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
    [tb_svf_stability.sv, top.sv]
2026-07-10 svf: remove superfluous clk — strobe directly as clock
    SVF state registers now clocked by @(posedge strobe) instead of
    @(posedge clk) with if(strobe) enable. strobe is a clean 96 kHz
    pulse — no need for a separate system clock in the filter.
    Filter datapath remains combinational. Coefficients (K, inv_res_K,
    inv_div) are still external ports — unchanged.
    Hardware-verified at 500 Hz Q=1.0 on Tang Nano 20K.
2026-07-10 svf: fix unsigned coefficient bug — wire signed on inv_res_K, inv_div
    inv_res_K and inv_div were declared unsigned (wire [17:0]),
    making all multiplies unsigned × signed = unsigned. This silently
    corrupted the product, wrapping 18-bit results and causing massive
    DC offset and gain error at high cutoff frequencies.
    Fix: wire signed [17:0] inv_res_K, inv_div. K stays unsigned
    (Q0.24 format is correct).
    Also: 160×8 LUT with 16/octave, 10-octave sweep, \u221a2/2\u201316 Q range.
    Sweep prescaled for ~1 second. Hardware-verified clean sweep
    across full range on Tang Nano 20K.
    [top.sv]
2026-07-11 tb_svf: fix Q0.24→Q3.14 shift (>>>6→>>>9) and use signed phase for bipolar sawtooth
    Testbench was feeding the SVF an 8× too-large unipolar sawtooth:
    - >>>6 instead of >>>9 (mismatched top.sv:148)
    - unsigned phase reg instead of signed
    This caused RTL output to saturate at ±130k Q3.14 (vs golden ±0.56).
    After fix: RTL range -0.44..+0.58 matches golden -0.56..+0.58.
    Remaining ~15% difference is expected Q3.14 quantization (see references/svf-golden-verification.md).
2026-07-13 Fixing Makefile, comments and misc details.
    [top.sv]
2026-07-13 rtl: add SPDIF transmitter module (IEC 60958, 96 kHz, 24-bit)
    Standalone biphase-mark encoded SPDIF output:
    - 98.304 MHz clk, /8 cell tick (12.288 MHz)
    - 96 kHz sample_strobe from I2S clock gen
    - M/W preambles, even parity, LSB-first
    - c_bit port for future channel status block
    - Verified in iverilog: all-zeros and 0xAAAAAA patterns
2026-07-13 rtl: integrate SPDIF transmitter into top level
    - Add spdif_out output port to top.sv (pin 27, LCD_B7)
    - Instantiate spdif_tx after I2S latch, fed from audio_sample
    - Mono for now: same signal on both L/R channels, c_bit tied low
    - Add pin constraint: LVCMOS33, DRIVE=8, PULL_MODE=UP
    - Add source file to build.tcl
    - iverilog: compiles clean, zero new warnings
2026-07-13 build: fix headless Gowin with xvfb-run
    QT_QPA_PLATFORM=offscreen fails on Qt/GLX (Gnome+Wayland).
    xvfb-run provides a virtual X server — Gowin works reliably.
2026-07-13 rtl: disable I2S output path, keep SPDIF only
    MAX98357A disconnected — SPDIF is now the primary audio monitor.
    I2S TX and data latch guarded behind .
    i2s_clock_gen stays (provides sample_strobe for voice pipeline + SPDIF).
    Ports driven to 0 when disabled (pa_en=0, amp safe).
    Re-enable: uncomment i2s_tx.sv in build.tcl, add -D ENABLE_I2S.
2026-07-13 docs: update README for SPDIF, I2S disable, retired coeff computer
    - Architecture: add SPDIF path, mark I2S disabled, remove coeff computer
    - Pinout: add spdif_out on pin 27
    - Directory: add spdif/, remove retired LUT/reciprocal/coeff files
    - Scripts: update to current gen_coeff_lut.py + gen_sine_lut.py
    - Status: SPDIF hardware-verified, coeff computer marked retired
2026-07-18 Add reference filter implementation in C
2026-07-18 Oscillator width in parameters package
    [params_pkg.sv]
2026-07-22 Fixed comments for filter.
2026-07-31 Added ESP32-C3 application processor
2026-07-31 Added SPI slave, signal name fixes, cleanup, new docs
    [spi_slave_regs.sv, top.sv]
2026-08-12 Basic SPI actually working; better supersaw test
2026-08-17 Cleanup, minor SPI stuff
2026-08-20 Add documentation of MIDI circuit
2026-08-20 rtl: SCMO 'drum' refactor — 256-voice sysclk pipeline
    - drum.sv: single timebase (1024 sysclk = 1 sample); sample_tick + voice_enter
    - voice_pipeline.sv: 12-stage SCMO pipeline x 256 voices (osc -> 2 SVFs ->
    log-gain stereo attenuation -> mix); state/param BSRAMs; DSPs inferred
    from plain multiplies
    - audio_clock.sv removed: i2s_tx is now a self-contained I2S master;
    spdif_tx consumes the drum tick and emits preamble cell 0 immediately on
    tick so frames stay contiguous and receivers lock
    - test patch (scripts/gen_test_patch.py): C-major chord across octaves,
    32 notes x 8 unison, hard-panned by unison index with inter-channel detune
    - gen_att_lut.py: attenuation log-gain decode LU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
2026-08-20 app: route MIDI messages through an event bus
    - event_bus.c/h: tiny pub/sub fan-out with per-subscriber drop counters;
    publishers never block on slow consumers
    - midi_log.c/h: console task subscribed to the bus, keeping printf out
    of the MIDI RX path
    - midi_in.c: parser callback publishes complete messages to the bus
    instead of printing
    - main.c: init bus and consumers before midi_in_init()
    - CMakeLists: add event_bus.c and midi_log.c
2026-08-21 rtl: register bank decoder layered on proven spi_slave (Step 1)
    Add reg_banks.sv — a dual-clock dual-port BSRAM register store driven by
    spi_slave's done/received_data handshake. Reuses the proven SPI
    transceiver unchanged; the BSRAM write port (sclk) and read port (sysclk)
    are the CDC. Command byte + data byte protocol, single-byte registers.
    Testbenches: tb_spi_basic (send 0xAA -> received_data==0xAA) and
    tb_reg_banks (end-to-end write + readback with isolation). make sim now
    runs sim-spi + sim-banks in addition to the existing pipeline/outputs.
2026-08-21 LED blink test: magic 0x55 in STATUS blinks LED + fix firmware CS framing
    FPGA (top.sv): led[0] blinks at sysclk/2^26 (~1.5 Hz) when STATUS[7:0]
    equals the magic value 0x55, confirming the full ESP32 -> SPI -> BSRAM ->
    FPGA loop on real hardware.
    Firmware (spi_regs.c): fix the burst-write misimplementation. The old
    code raised CS between command and data bytes (one fpga_xfer_byte per
    byte). Rewrite to send command+data in a SINGLE spi_device_transmit
    (native burst) so CS stays LOW across the whole frame, matching the
    FPGA's command/data framing. main.c now writes 0x55 to STATUS instead
    of the old echo test.
    [main.c, spi_regs.c, top.sv]
2026-08-21 Add SPI/BSRAM memory map.
2026-08-28 spi: fix both directions — give the slave a byte boundary
    The SPI link had one structural fault per direction, both from the same
    root cause: spi_slave tracked bits, not bytes, so it could neither commit
    a received byte nor load a byte to send at a byte boundary.
    TX (the observed symptom — "one constant byte works, anything else
    returns 0x00"): shift_out was loaded only on the CS rising edge, i.e. at
    the end of the *previous* transaction, then shifted left with zero fill.
    Byte 0 carried the stale constant and read correct; every later byte was
    structurally 0x00. A value computed during the transaction (mem[addr], a
    loopback of the received byte) had no load path at all.
    RX: spi_slave r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
    [main.c, spi_regs.c, spi_regs.h, spi_slave_regs.sv, tb_spi_slave_regs.sv, top.sv]
2026-08-28 spi: declare power-up state; fix testbench string arg
    Two fixes found by running the real toolchain (iverilog 12.0 + yosys
    0.67 on thj.no), neither of which the hand model could have caught.
    1. spi_slave_regs.sv — every reset in the module is `posedge cs`, and at
    power-up CS is already high: it goes 1->0 for the first transaction,
    so that edge never occurs and nothing is reset before the first frame.
    Gowin FFs leave configuration at 0 so hardware would have been fine,
    but the state was never declared, so a simulator starts them at X and
    the entire first transaction decodes to garbage. The bench caught it
    precisely: tests 2 and 3 (the first write, and reading it back) fai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
    [spi_slave_regs.sv, tb_spi_slave_regs.sv]
2026-08-28 docs: record measured SPI link speed — clean to 40 MHz
    Verified on hardware (thor-mini-linux + Tang Nano 20K + ESP32-C3), with
    the new spi_slave_regs bitstream loaded into FPGA SRAM:
    11 rates from 1 MHz to 40 MHz, 8 repetitions each. Every repetition
    wrote four registers, burst-read them back and checked the ID byte
    plus all four values. 88/88 correct, no degradation at any rate.
    40 MHz is the ESP32-C3's ceiling for SPI2 through the GPIO matrix (the
    configured pins are not the IOMUX ones) — the link never failed, the
    master ran out. nextpnr closes the u_spi.sclk domain at 230-269 MHz, so
    the slave was never the constraint.
    This settles an open question in the memory map, which p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
2026-08-28 docs: settle the dual-clock BSRAM CDC question — it works
    Decision 7 carried a risk note: "if yosys cannot infer dual-clock BSRAM,
    fall back to an inbox/commit design." Nobody had tested it, and the whole
    CDC stance for the 64K map rests on it. Tested now, on the real toolchain
    (yosys 0.67 / nextpnr-himbaechel / gowin_pack, GW2AR-LV18QN88C8/I7):
    semi dual-port, 2 clocks, 2048x36 -> 4x DPX9B, packs, builds
    same + ping-pong bank-select in addr -> 4x DPX9B, unaffected
    true dual-port, both ports read+write -> ERROR: no valid mapping
    256x36 -> 0 blocks (LUT-RAM chosen)
    Place-and-route on the real part: BSRAM 4/46, clock domains closing at
    549 MHz an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
    [spi_slave_regs.sv]
2026-08-28 docs: correct the BSRAM claim — it builds, it is not verified
    The previous commit said the dual-clock BSRAM CDC question was
    "resolved" and decision 7's fallback was "not needed". That over-claimed,
    and the challenge was fair. Correcting it.
    What was actually established: yosys infers dual-clock BSRAM, nextpnr
    packs it (BSRAM 4/46), gowin_pack emits a bitstream, and a netlist audit
    shows CLKA and CLKB on genuinely distinct nets with write-enable only on
    the A port. The structure is right.
    What was NOT established: that any of it behaves correctly. And in this
    flow it cannot be, because every Gowin BSRAM primitive in oss-cad-suite
    (SP, SPX9, SDPB, SDPX9B, DPB, DPX9B, pROM) is a blackbox i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
2026-08-28 spi: add read-only STATUS window so the FPGA can report its own state
    Adds the fabric -> host read path the memory map specifies at 0x001
    STATUS, which until now did not exist in any form: the register store
    could only ever return what the host had previously written to it.
    Addresses RO_BASE..NWORDS-1 read a byte of a new `status_in` port instead
    of the RAM. RO_BASE defaults to NWORDS, so with no parameter override the
    whole read-only path is a compile-time constant false and the module
    behaves exactly as before — the existing tests are unaffected.
    CDC: status_in changes continuously in the sysclk domain, so sampling it
    byte-by-byte from the sclk side would tear a multi-byte value across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
2026-08-28 spdif: block sync + channel status — what a receiver actually requires
    B preamble every 192 frames and a valid channel status block (consumer
    PCM, 96 kHz byte3=0x0A, 24-bit byte4=0x0B). The old c_bit=0 tie declared
    44.1 kHz for a 96 kHz stream; PREAMBLE_B existed only as a comment. A
    pro interface frames channel status off the B preamble, so without one
    it never reports lock.
    The fixed-polarity preamble trick is now documented where it lives: even
    parity guarantees the line returns low before every preamble.
    tb_spdif_block.sv decodes two full 192-frame blocks: preamble cadence
    (B/M/W), biphase parity, payload integrity, and the assembled CS bytes.
    Also removes two stale testbenches that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
    [spdif_tx.sv, tb_outputs.sv, tb_spdif_block.sv]
2026-08-28 spdif-minimal: drum + spdif alone, clocked from the 27 MHz crystal
    The smallest thing that can put a valid SPDIF stream on the coax: rPLL
    multiplies the always-present 27 MHz crystal (pkg pin 4) by 11/3 to
    99.0 MHz, the drum divides by 1024, a 1.5 kHz square at -18 dBFS feeds
    spdif_tx. Fs = 96.68 kHz; receivers lock to the actual bit rate, so
    this works on a board whose MS5351 was never configured.
    The SPI counter instrument stays in so the PLL rate is measured over
    SPI, not assumed. led[5] = PLL lock.
2026-08-28 tb_spdif_block: decode every frame, not every other one
    The frame-complete check wrote ci in the same cycle as the next
    sample_tick reset; the later non-blocking write won, ci stuck at 129,
    and the bench skipped alternate frames. All block-start frames fell in
    the skipped half, so it reported B missing from a stream that carried
    it, and assembled channel status from the odd-indexed bits (the observed
    {12,13,16,17} = bits {25,27,33,35} of the real block, halved).
    Same lesson as tb_reg_banks: when a bench fails, decode WHICH wrong
    answer it produced before trusting it over the DUT.
    [tb_spdif_block.sv]
2026-08-28 tb_spdif_block: release reset off the clock edge
    Blocking rst_n release at a posedge races the DUT always blocks: the DUT
    starts frame 0 on that edge, the bench misses the first sample_tick and
    labels every frame one late -- B missing at 192k and channel status
    read as CS_FLAT[f+1]. Release on the falling edge so DUT and bench see
    the same first tick.
    [tb_spdif_block.sv]
2026-08-28 tb_spdif_block: print frame-1 cells for A/B against the 052d920 stream
    Frame 1 is an ordinary M-frame with CS bit 0, so it must be
    bit-identical to what the confirmed-working 052d920 build emitted.
2026-08-28 spdif-minimal: mirror the stream on pkg pin 56
    Every bitstream loaded on the new board before the PLL fix had a dead
    sysclk, so pin 27 has never been observed toggling on this board. The
    mirror gives a second probe point: signal on 56 but not 27 = pin 27
    path; neither = deeper; lock via a jumper from 56 = pin 27 damaged.
    [top.sv]
2026-08-28 docs: SPDIF debug toolkit — A/B result, in-fabric cell snapshots
    The drum-based stream is bit-identical to the audio_clock-era stream
    confirmed working on hardware. The FPGA can verify its own output: 64
    live cells snapshotted into the SPI STATUS window per CS assert, decoded
    by the run-of-3 rule (biphase data never has one; preambles always do).
    Measured on hardware: 14/16 snapshots valid IEC 60958, 2 edge-truncated.
2026-08-28 spdif: exact 96.000 kHz via fractional cell DDS
    The Focusrite detects the stream but refuses lock and falls back to
    44.1 kHz — the signature of rate-window validation, and our crystal-PLL
    stream runs +0.7% high (96,688 Hz). Exact rate needs exactly 98.304 MHz,
    which 27 MHz cannot reach: 98.304/27 = 4096/1125, and no in-spec rPLL
    ratio (single or cascaded — PFD floor kills every factorization of
    1125) produces it.
    So the cell timebase goes fractional: spdif_tx now takes cell_tick as
    an input, and the top feeds it from an accumulator (+512 mod 4125 per
    99 MHz cycle) whose average is 12.288000 MHz exactly. 128 cells per
    frame gives Fs = 96,000.000 Hz to the crystal's ppm. Cells are 8 or 9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
2026-08-28 spdif: cell_dds module + jitter-aware end-to-end testbench
    The fractional timebase was living only in top.sv, unsimulated — the
    exact place an off-by-one makes 127/129-cell frames that average to
    128.000 and pass a rate measurement while a receiver rejects every
    frame. It is now its own module, so the same source is verified by
    tb_spdif_dds.sv and synthesized by top.sv.
    The bench checks what the uniform-cell bench cannot: every frame is
    exactly 128 cells under 8-or-9-cycle jittered cells, cell lengths are
    only ever 8 or 9 with the 4125/512 average, plus the usual preamble
    cadence / parity / payload / channel status.
    CMakeLists gains esp_timer so rate measurements are microsecond-grade
    (c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
    [top.sv]
2026-08-29 docs: SPDIF audible on hardware; correct the serial-port map
    Sound confirmed on the Focusrite via the fractional-DDS exact-96k
    stream (distortion noted, unresolved). ttyUSB1 is the FPGA UART bridge
    and is rightly silent when the bitstream has no UART; earlier notes
    misread that as a BL616 fault. No debugger reflash was needed.
2026-08-29 mainline return: 256 voices -> SPDIF on the real 98.304 MHz clock
    The MS5351 on this board is configured (pll_clk O0=98.304M -s, done at
    the bench 2026-08-29), so pin 10 carries the real sysclk again and the
    workaround stack retires: no rPLL, no fractional cells. The drum
    free-runs /1024 -> exactly 96.000 kHz with uniform /8 cells, the
    256-voice pipeline reconnects unchanged, and spdif_tx keeps the branch
    fixes (B preamble, channel status) via its cell_tick port.
    cell_dds stays in the tree as the documented crystal-only fallback but
    is out of the build. I2S remains disconnected pending confirmation of
    what is wired to pins 54-56. STATUS window now reports sysclk and
    sample-tick counters so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
    [top.sv]
2026-08-29 rtl: drum owns the cell tick; top.sv back to pure composition
    'drum.sv is the sole timebase' made literal: the SPDIF cell boundary is
    a decode of the slot counter the drum already owns (slot[2:0]==0, so
    1024 = 128 cells x 8 and alignment with sample_tick holds by
    construction, not by convention between separate counters).
    top.sv sheds everything that had accreted onto it -- the local cell
    divider, edge counters, diagnostic STATUS plumbing -- and is composition
    again: drum, pipeline, spdif, spi, one liveness LED. The instrumented
    diagnostic tops live in this branch's history when needed.
2026-08-29 rtl: reconnect I2S — same veroboard, same pinout
    Confirmed the new Tang sits in the same veroboard slot with unchanged
    wiring, so pins 54-56 carry I2S exactly as before. i2s_tx returns to the
    build and to top.sv in its mainline form (self-clocked master, BCLK =
    sysclk/16, latches on the drum's sample_tick), and tb_outputs — which
    decodes the SPDIF cell stream AND checks the I2S clock rates — rejoins
    `make sim`.
2026-08-29 spi: memory-map wire protocol — spi_bus.sv + firmware word API
    The docs/memory_map.md transaction format, implemented: command byte
    ([7] R/W, [6] auto-increment) + 16-bit address + streaming 32-bit data
    words, MSB first (byte-order choice documented; not specified in the
    map). Wire format is decoupled from storage geometry: the protocol
    speaks the full 16-bit space while an 11-bit window (2048 x 36-bit
    dual-clock BSRAM) backs it. Out-of-window writes are dropped and reads
    return zero -- no aliasing.
    Reads carry a 2-byte turnaround after the address: the store's read
    port is in the sysclk domain (true dual-port BSRAM does not map --
    measured), a fetch costs ~60 ns, and the first data byte'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
2026-08-29 spi_bus: latch the outgoing word per word boundary
    The TX mux read resp live, so the next-word prefetch (or a single-word
    frame prefetching its empty neighbor) overwrote it mid-word and clipped
    the tail bytes -- all 13 bench failures, one cause. tx_word latches at
    each word boundary in the sclk domain; resp is then free to change
    under later prefetches.
    [spi_bus.sv]
2026-08-29 svf: give the states their headroom -- fixes noise below ~14 kHz cutoff
    Reported from the bench: any cutoff below 0x2AF8 (~14 kHz) produced
    noise; the filter only worked wide open, including with FC = pitch for
    key tracking.
    Cause: audio entered the filter as osc <<< 18 -- Q2.16 landing 64x hot
    in the Q8.28 state format, using up the 8 integer bits the design doc
    reserves as overshoot headroom. Wide open, hp stays tiny and nothing
    overflows; with the cutoff below the input's energy, hp = in - lp - q*bp
    sums three near-full-scale terms, wraps the 36-bit state, and the wrap
    feeds back through ic1/ic2 -- sustained noise. The K decode itself is
    correct (verified numerically across octaves); the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
    [voice_pipeline.sv]
2026-08-29 svf: split adder trees from multiplies -- fixes the silicon crackle
    Bench experiment, definitive: with fc=0x1000 the same bitstream crackles
    ("rain on a metal roof") at 98.304 MHz and is smooth at 49.152 MHz, and
    the same RTL + hexes render glassy smooth in simulation (max sample step
    -52 dBFS, verified by ear on rendered WAVs). Identical computation,
    double deadline, no crackle: a data-dependent setup violation, on the
    stage that chained three 36-bit adds straight into the 36x36 DSP
    multiply (S5/S8: hp = in - lp - q*bp feeding K*hp in one cycle).
    Low-cutoff operation parks the states near full scale creeping by small
    increments -- exactly the operand pattern that fires full-length carry
    rip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
    [voice_pipeline.sv]
2026-08-29 svf: S6 was a chimera -- half its inputs read one stage too early
    The S5B insertion left S6 consuming a mix of s5b_* (m3, ic1eq1, ftype)
    and s5_* (lp1, hp1, everything else): voice v's multiply combined with
    voice v+1's adder outputs. Cross-voice state corruption pumped energy
    into the filters -- the avalanche heard on the bench, clock-invariant
    because it is pure logic. Reproduced in sim (peak growing 2.5M -> 7.4M
    by sample 4000) before fixing; the bulk edit that converted S6 had
    silently failed on two of three blocks and a reference count gave false
    confidence. All S6 inputs now come from S5B; a stage-skip audit shows
    zero s5_/s8_ references beyond their following stage.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
    [voice_pipeline.sv]
2026-08-29 svf/att: register the gain decode before the stereo multiply (S9B)
    Half-clock A/B from the bench: right channel heavily distorted at
    98.304 MHz, both channels clean at 49.152 MHz -- another data-dependent
    setup violation, and the channel asymmetry localizes it: voices are
    shared hardware, the channels only diverge in the attenuation stage,
    where each channel chained att_lut read + 16-position barrel shift into
    an 18x18 multiply in one cycle. Two structurally identical paths; the
    right drew the longer route on this build.
    S9B registers the decoded gains; S10 multiplies registered operands.
    Depth 14 -> 15, span 270 slots, writeback spacing 14 -- collision-free.
    Known same-class residual, del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
    [voice_pipeline.sv]
2026-08-29 tb_voice_pipeline: atten cross-check tracks the S9B latency
    The check assumed s10 is driven by the previous cycle s9 values; with
    the S9B decode stage between them it is two cycles. The latency-agnostic
    mixer check passing throughout confirmed the datapath values were right;
    only the bench model was stale.
2026-08-29 docs: verified — working filter and clean SPDIF on hardware
    Bench-confirmed by ear at full SYSCLK and at SYSCLK/2: the low-cutoff
    patch (fc=0x1000) plays a clean muffled chord on both channels through
    SPDIF after the S5B/S8B/S9B timing splits. ESP32 SPI test re-run: still
    OK/PASS. AGENTS.md now carries the silicon timing rule (decode/adds-only
    or multiply-only per stage) and the diagnosis method that found it:
    sim-vs-silicon A/B plus the reversible half-clock listen.
2026-08-29 docs: pipeline notes updated to the 15-stage reality
2026-08-29 control plane: integration flip to the memory-map wire protocol
    top.sv swaps the byte-protocol bring-up slave for spi_bus (16-bit word
    addresses, 32-bit data, 11-bit backed global window), and main.c
    replaces the byte self-test with a word-protocol one mirroring
    tb_spi_bus.sv cases: single write/read, burst auto-increment, and the
    out-of-window drop/zero/no-alias contract. spi_slave_regs.sv stays in
    the tree as reference with its bench still in `make sim`.
    First rung of the GATE ladder (gate before ADSR, per bench decision):
    the control plane must be live and verified before the first writable
    per-voice register exists.
    [main.c, top.sv]
2026-08-29 tb: voice bench owns its patch -- committed reference fixtures
    tb_voice_pipeline compared the DUT against expectations built for the
    committed open-filter patch while the DUT read whatever hexes the tree
    held -- so any bench-side experiment in scripts/gen_test_patch.py made
    the suite cry wolf (it did, twice). The patch ROM paths are now module
    parameters; the bench overrides them (DUT and its model both) with
    rtl/tb/ref_patch_*.hex, committed fixtures generated from the committed
    script. Synthesis keeps the tree hexes via the defaults.
    [tb_voice_pipeline.sv, voice_pipeline.sv]
2026-08-29 per-voice parameters writable over SPI; single voice programmable
    spi_bus decodes the memory map's per-voice range (0x2000 + v*64,
    offsets 0..3 = OSC/DUTY/FILTER/GAIN) into a combinational write port,
    valid on the same sclk edge that completes a data word (a master may
    never clock again after the last bit -- the lesson spi_bram taught).
    The param RAMs in voice_pipeline grow an sclk write port; their reads
    become synchronous on sysclk (same timing as the old comb-read+register,
    but the shape yosys infers as dual-clock BSRAM -- the BSRAM is the CDC,
    per the design doc). Hex init remains the boot patch.
    tb_voice_program drives the whole path with a Mode 0 master: boot organ
    audible, mute-all v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
2026-08-29 tb_voice_program: flush the in-flight sample before the silence check
    The last gain write races the drum rotation; the sample being
    accumulated when the SPI frame ends still carries pre-mute
    contributions, and the silence check caught its peak. RAM contents and
    steady-state were proven correct by instrumented debug (all p3 words
    0x0FFFF, residual exactly 0). Four settle samples before measuring.
    [tb_voice_program.sv]
2026-08-29 MILESTONE: synth programmable over SPI — verified on hardware
    The control plane is real: the ESP32 programs voices at runtime through
    the memory-map wire protocol (16-bit addresses, 32-bit words), verified
    in simulation (7 green benches, including a Mode 0 master programming a
    single A4 voice and checking its 440.0 Hz periodicity) and on hardware
    by ear (boot organ -> mute-all silence -> constant tone -> triangular
    pitch sweep via firmware).
    Includes the bench-side sweep test in main.c and the low-cutoff test
    patch in gen_test_patch.py.
    Known issue, next branch: occasional clicks during parameter sweeps --
    same-address read-during-write collisions on the dual-clock param BSRAM
    (the pipel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
    [main.c]
2026-08-29 ping-pong patch banks: collision-free parameter updates
    Memory map decision 7, implemented for the per-voice banks. The banks
    double ({bank, voice} addressing, both halves hex-initialized -- an
    all-zero shadow would be 0 dB gains, not mute); pipeline reads always
    hit the ACTIVE half and SPI writes always the SHADOW half, so the
    same-address read-during-write collision behind the sweep clicks cannot
    occur, by construction. The flip is requested via CTRL@0x0002 bit 0 (an
    sclk toggle out of spi_bus) and executes at drum slot 512, where the
    pipeline is drained -- every sample reads one consistent bank
    generation, and whole-patch updates become atomic.
    Firmware: fpga_patch_flip() (request + 21 u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
    [main.c, spi_bus.sv, spi_regs.c, spi_regs.h, tb_voice_pipeline.sv, tb_voice_program.sv, top.sv, voice_pipeline.sv]
2026-08-30 docs: corrections and thoughts from Thor
    Terminology (everything is live, no 'patch'), no gateware PLLs ever, 36-bit chain question, post-LUT smoothing idea, synth_pkg consolidation, ESP32 MIDI structure discussion.
2026-08-30 apply Thor's corrections: everything is live, no gateware PLLs
    Terminology: the banked per-voice data is not a "patch" and the swap
    is not a patch operation -- everything is live, every change is
    effected through a swap (thousands per second are fine). Renamed
    fpga_patch_flip() to fpga_swap(), reworded comments and docs to "boot
    image"/"parameter data", and removed the patch-vs-live class
    distinction from design.md and memory_map.md ("patch panel" survives
    as the CV-routing metaphor, per Thor). File names still carrying
    "patch" (test_patch_p*.hex, ref_patch_*, gen_test_patch.py) are
    deferred to the synth_pkg housekeeping pass to avoid churning fixtures
    mid-verification.
    Gateware PLL fallbac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
    [main.c, spdif_tx.sv, spi_bus.sv, spi_regs.c, spi_regs.h, tb_voice_pipeline.sv, tb_voice_program.sv]
2026-08-30 MILESTONE: ping-pong bank swap verified by ear — sweep is click-free
    Thor confirms the cutoff sweep that clicked against single-banked
    param RAM is click-free with write-shadow + swap. Verified-state notes
    updated in design.md and AGENTS.md.
2026-08-30 docs: approved firmware architecture + roadmap
    firmware_architecture.md: the approved three-module ESP32 structure --
    midi_in (parse) -> synth model (musical state, host-testable, no SPI)
    -> engine link (sole owner of SPI and the shadow-bank discipline,
    fixed 1 kHz tick, write-batch + swap). Sequencers later are just
    another producer into the same command queue.
    design.md: smoothing design marked approved (post-LUT per-voice LPF,
    10 fractional guard bits, snap-on-GATE) and a roadmap section with the
    agreed rung order: housekeeping -> GATE -> smoothing -> firmware ->
    (ADSR / 36-bit summing / routes / LFOs). Firmware deliberately after
    GATE+smoothing so the allocator is written once against f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
2026-08-30 docs: settle terminology — elements, lanes, voices
    Thor's decision: the FPGA *generates* elements (256 of them),
    technically via lanes (the time-multiplexed pipeline passes); the
    ESP32 allocates and groups elements as it wants, e.g. into voices.
    User-facing scope via MIDI/control surfaces is explicitly still open.
    Identifier renames to match land in roadmap rung 1 (housekeeping).
2026-08-30 app: voices as a concept — engine link + voice allocator
    The two approved modules land (firmware_architecture.md):
    engine_link -- sole owner of the SPI link. A command queue mutates a
    local image of the 256x4 element parameter space; a 1 kHz tick drains
    the queue, writes this tick's dirty words UNION last tick's (the
    shadow catches up on the generation it missed), and swaps. Skips the
    swap entirely on quiet ticks. Mutes both banks at init. SPI raised
    1 -> 10 MHz (measured clean to 40): at 1 MHz a note-on's 32 words
    would blow the 1 ms tick.
    voice_alloc -- the first grouping of elements into voices: 32 voices x
    8 elements in fixed blocks, church-organ unison detune (same table as
    the boot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
    [engine_link.c, engine_link.h, main.c, voice_alloc.c, voice_alloc.h]
2026-08-30 fix: drop always-false uint8 range check (-Werror=type-limits)
    [engine_link.c]
2026-08-30 fix: pace the engine tick with esp_timer, not vTaskDelayUntil
    FreeRTOS ticks at 100 Hz, so pdMS_TO_TICKS(1) = 0 and xTaskDelayUntil
    asserts (xTimeIncrement > 0) -- boot loop on hardware. A 1 ms
    esp_timer now notifies the task: true 1 kHz, independent of the
    kernel tick.
    [engine_link.c]
2026-08-30 tb: chord-stress phase reproducing the scream report
    The firmware's exact write pattern: 4 voices x 8 saw elements around
    a C octave boundary, church-organ detune, hard-panned, fc one octave
    up, retriggered 4x. Asserts no near-clip output and bounded sample
    steps. Sim clean + hardware screaming points at silicon timing (the
    documented S3 k-shift -> S4 multiply residual risk -- fc octaves now
    vary per voice for the first time); the half-clock listen test then
    settles it.
2026-08-30 rtl: S3B timing split — register the K shift before the S4 multiply
    The fourth and last chain of the known silicon-timing class: S3's K
    barrel shift (k_lut <<< fc octave) fed the S4 DSP multiplies
    combinationally. Invisible while every element shared one fixed fc
    (boot organ, single-voice sweep: constant shift amount); the voice-
    concept firmware gave each voice its own fc octave, so consecutive
    lanes toggle the shift — chords screamed in the left channel at full
    SYSCLK, clean at half clock (Thor's half-clock test, the class's
    signature). Left-only because the lane right after a voice boundary
    is a left-panned element; screaming because a glitched K is an
    out-of-range cutoff.
    S3B regist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
    [voice_pipeline.sv]
2026-08-30 gain +6 dB; document the K-width constraint
    GAIN_BASE -36 -> -30 dB (Thor: raising base is enough for now;
    velocity curve unchanged). K stays 36-bit in the SVF multiplies --
    the LUT+shift expands to ~22+ bits of real precision, needed for the
    planned noise oscillator and whistling-filter melodies; comment added
    so nobody narrows it to save DSPs.
    [voice_alloc.c, voice_pipeline.sv]
2026-08-30 SYSCLK 98.304 -> 73.728 MHz: 768 slots, same 96 kHz (Thor's call)
    Fifth ear-verified silicon timing failure that STA passed (soft
    filtered crackle on chords, clean at half clock, clean in sim): after
    S3B the remaining suspect is the 36x36 MULT cascade itself,
    register-to-register, whose whole partial-product tree now toggles
    with per-voice K. Rather than splitting six multiplies into
    multi-cycle partials, step the clock down 25% and give every path --
    known and unknown -- the margin this fabric evidently needs near
    100 MHz.
    768 = 3 x 256: sample rate stays exactly 96 kHz, SPDIF cell 8 -> 6
    sysclk (12.288 MHz unchanged, drum grows a mod-6 cell counter), I2S
    BCLK divider 16 -> 12 (6.144 MHz u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
    [drum.sv, i2s_tx.sv, spdif_tx.sv, synth_pkg.sv, tb_outputs.sv, tb_spdif_block.sv, tb_spi_bus.sv]
2026-08-30 docs: smoothing deferred (ADSR-snappiness dilemma), splits experiment noted
    Thor's corrections written into the roadmap where they belong:
    smoothing is unscheduled until the modulation architecture resolves
    where a smoother can live without low-passing ADSR attacks (post-LUT
    smoothing vs pre-LUT envelope summing -- the unresolved dilemma is
    now spelled out in the smoothing section). And a rung for the
    some-point-later experiment of removing the S3B/S5B/S8B/S9B stage
    splits at 73.728 MHz, one at a time behind ear-verified tortures.
2026-08-30 housekeeping: elements/lanes everywhere, constants in synth_pkg
    The roadmap's rung 2, zero behavior change (benches must print
    identical numbers):
    - rtl/voice/ -> rtl/element/; voice_pipeline.sv -> element_pipeline.sv
    (module element_pipeline); tb_voice_* -> tb_element_*; make target
    sim-voice -> sim-elem.
    - Identifiers follow the settled terminology: NUM_VOICES ->
    NUM_ELEMENTS, voice_enter -> lane_enter (drum param NUM_LANES),
    pv_* -> pe_* (pv_voice -> pe_elem), s9_voice -> s9_elem.
    - The word "patch" leaves the file names: gen_test_patch.py ->
    gen_boot_image.py writing element/boot_p{0..3}.hex; committed
    fixtures ref_patch_* -> ref_boot_* (.gitignore keep-rule updated).
    - synt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
    [drum.sv, element_pipeline.sv, engine_link.c, osc_core.sv]
2026-08-30 GATE: per-element gate word at map offset +4 (roadmap rung 3)
    The map's ABI as specified: GATE[0] at 0x2000 + e*64 + 4, banked and
    swapped like every other parameter (pe_bank widens to 3 bits, decode
    accepts offsets 0..4). Gate 0 silences the element by forcing the
    gain decode to the exact-mute code -- one decode-stage mux into the
    existing mute machinery, no new pipeline carry registers, no timing-
    rule exposure. Oscillator and filters free-run while silent (as we
    like it); the gate edge becomes the ADSR trigger later. retrig[1]
    reserved.
    Both banks boot gated ON so the boot image keeps sounding as the
    power-up liveness check.
    Firmware: note-off is now GATE off, nothing else -- GAIN words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
    [element_pipeline.sv, engine_link.c, engine_link.h, spi_bus.sv, tb_element_pipeline.sv, tb_element_program.sv, top.sv, voice_alloc.c]
2026-08-30 gain +6 dB (base -18); mod wheel -> filter cutoff
    Thor measured full-smash chords at -12 dBFS, so another step up is
    safe. CC1 now sweeps the cutoff offset from +1 octave (wheel 0) to
    ~+4 octaves (wheel 127) by rewriting active voices' FILTER words --
    the first live CC route, firmware-computed until the FPGA CV/route
    machinery exists. Duplicate CC values skipped; zipper on fast sweeps
    expected until smoothing.
    [voice_alloc.c]
2026-08-30 pitch wheel: +/-2 semitone bend across active voices
    0xE0 14-bit bend -> UQ4.10 offset ((bend-8192)/48, ~85.3 LSB per
    semitone), applied with detune in one shared OSC-word bake used by
    both note-on and live bend updates. Cutoff stays keyed to the unbent
    note (bend-following key tracking rides a CV cell later, per the
    memory map). Duplicate values skipped.
    [voice_alloc.c]
2026-08-30 MILESTONE: GATE + wheels verified by ear (Thor)
    Gate semantics, mod wheel -> cutoff, pitch wheel +/-2 semitones, gain
    at -18 dB/element -- all approved on hardware. Roadmap rung 3 done.
2026-08-30 fix: restore design.md mangled by a PowerShell replace
    The milestone commit's design.md edit used a PowerShell -replace,
    which re-encoded the whole file (UTF-8 read as ANSI: mojibake dashes
    and emoji, plus a BOM). Restored byte-exact from the parent commit
    and re-applied the roadmap updates with a proper editor. The standing
    rule exists for a reason; violated it, paid for it.
2026-08-30 docs: modulation redesign direction -- mod buses (Thor)
    Sinks per element are known and fixed, so each is a summing bus with
    a small fixed slot count, replacing the generic 8-cable crossbar.
    Velocity is a source via a per-note CV cell. Open: in-pipeline vs
    decoupled control-rate evaluation; LFO bank shape.
2026-08-30 docs: one-to-many indirection in the mod model (Thor)
    SPI bandwidth demands elements reference shared config rather than
    own copies: element -> profile index -> bus slot table. Patch-wide
    mod changes become one write. Candidate name for the profile: stop.
2026-08-30 docs: buses are memory, parameters hold pointers (Thor)
    Effective parameter = base + bus[index]: add-only in the audio
    pipeline, all scaling producer-side in idle slots. Unifies CV table
    and buses into one bus memory; combiner producer for multi-source
    sinks; pointers live in the stop.
2026-08-30 docs: everything is a bus -- base registers + producers (Thor)
    Parameters point at buses; each bus = ESP32-settable base + producer
    sums; direct control is the degenerate one-bus-per-param allocation.
    Sink-typed bus memories fix units and read ports. Bus law: buses add,
    only producers multiply. Open: detune offset vs per-element pitch
    buses; swap governs wiring, buses carry signal.
2026-08-30 docs: bus chaining via producer table order
    Combiners already make chains; the one-rule semantics (producers run
    in table order, reads see current memory) makes ordered chains
    zero-lag and cycles a defined one-sample delay. Graph bookkeeping
    stays in firmware.
2026-08-30 docs: the bandwidth-vs-complexity balance governs the bus build
    Every bus feature has a firmware fallback costing SPI traffic, so
    the line is tunable on measured link utilization. Tiering: bus
    memories/pointers/bases + LFO producers first; ADSR producers with
    envelopes; combiner and stop tables deferred until data demands them.
2026-08-30 docs: ADSR as producer; dumb elements; frozen pipeline goal (Thor)
    Envelopes come from the producer pool, shared per element group via
    buses; triggering rides a gate bus. Elements reduce to waveform,
    filter type, detune and pointers -- the audio pipeline freezes
    permanently once the pointer fetch lands; all future features are
    producer types.
2026-08-30 spec: buses are signed Q8.10 -- octaves.fraction (Thor, B0 review)
    One format with one musical meaning: integer octaves + 10-bit
    fraction works identically on pitch, cutoff and gain (6 dB = 1
    octave); duty maps -1..+1 to 0-100% (11-bit mod resolution accepted,
    revisit on audible evidence); Q convention TBD at B2; consumers use
    saturating adds.
2026-08-30 spec: B0 review state -- detune decided, producer pool 128
    Detune stays a per-element static offset (Thor: conceptually a bus,
    but too common not to dedicate); one pitch bus per voice, one base
    write per note-on. Producer pool 64 -> 128 (ADSR pairs at full
    polyphony ate 64 alone; LFOs need room) -- 256 of ~497 idle slots,
    <=200 multiplies on one DSP lane. Status header records what's
    settled in review and what remains open before sign-off.
2026-08-31 spec: B0 review round -- routing before ADSR, clarity fixes
    Milestone B3 becomes firmware-routed buses (velocity -> gain,
    velocity -> cutoff, pitch wheel -> pitch offset) per Thor: basic
    routing is testable before any producer exists, and it absorbs the
    old per-note-cells rung. Walker/LFO and ADSR shift to B4/B5.
    Clarity per Thor's feedback: terminology block up front (firmware =
    ESP32 C, gateware = FPGA SystemVerilog, silicon = the physical
    chip); the sink-typed-memories leftover in the constraints table
    corrected to the uniform Q8.10 pool; the rejected per-element-
    envelope bullet elaborated to name the design era it refers to
    (256 elements x 2 ADSR register sets = 512 gateware envelopes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
2026-08-31 spec: B0 corrections -- stop unnamed, replication justified, full pointers
    Thor's review round: 'stop' was organ-analogy chat, not terminology
    -- removed from the terminology block, the B6 concept is explicitly
    unnamed. The six sinks are named and the 6x replication is justified
    in full (one read port per inferred BSRAM; six concurrent reads per
    cycle because every stage holds a different element; broadcast
    writes keep copies identical). Pointers are 10 bits from day one --
    no held-back address bits.
2026-08-31 B1: cutoff bus pilot -- the bus fabric's first sink
    Gateware: bus RAM (1024 x signed Q8.10, one replica for the pilot;
    bus 0 hardwired zero), per-element pointer word at map offset +5
    (three 10-bit fields, full width per B0 review, riding the ping-pong
    banks -- pointers are wiring), and the effective-cutoff saturating
    add feeding the K-LUT address at S2->S3. No new pipeline stage: the
    pointer rides the S1 param read and the bus fetch lands at S2, so the
    "one add stage" the spec budgeted turned out to cost zero stages.
    CDC: SPI bus-base writes (0x0800..0x0BFF) cross through a 1-deep
    toggle mailbox committed to bus RAM only in idle drum slots (lane bus
    reads issue during slots 1..~257, commit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
    [element_pipeline.sv, engine_link.c, engine_link.h, spi_bus.sv, synth_pkg.sv, tb_element_pipeline.sv, tb_element_program.sv, top.sv]
2026-08-31 MILESTONE: B1 verified by ear -- mod wheel rides the bus (Thor)
    Spec ladder updated: B1 done, including the measured result that the
    live bus sweep is smoother than the swap-based sweep (10240 vs 38144
    worst sample step).
2026-08-31 B2: all six sinks on buses
    The remaining five sinks join cutoff on the bus fabric: six replicas
    of the uniform pool (broadcast writes keep them identical -- the
    "Why six replicas" justification from B0 review, now built), pointer
    word PTRS1 at map offset +6 (Q, gain L, gain R), and six parallel
    saturating adds at the S2->S3 boundary -- adds/decode only, still
    zero new pipeline stages.
    Per-sink slices of the Q8.10 word, per spec law 5: pitch/cutoff
    as-is, duty <<< 13 (bus +/-1.0 = duty +/-1.0), Q <<< 6 (declared at
    this milestone: bus +/-1.0 = q1 +/-1.0 in Q2.16), gains >>> 6
    (1 octave = 6 dB = 16 UQ4.4 steps; positive bus = quieter). A gain
    base of 0xFF (exact mute: hard-panned channels, ga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
2026-08-31 tb: pitch-bus check on a sine -- rise counting on a filtered saw lies
    The B2 rev-1 bench counted 12 rises/2182 samples at C4 (a filtered
    saw sum recrosses zero); the doubling assertion was built on ~6.
    Reprogram the sounding elements to an undetuned C4 sine before the
    pitch-bus test, matching the proven 440 Hz tone check. Gain-bus
    assertions already passed (299520 -> 70912 at +12 dB, restored).
2026-08-31 tb: SVF stability characterization bench (sim-stab)
    Thor's ask before setting the FC_MAX clamp: measure the real
    stability boundary across cutoff x Q instead of trusting the one
    q1=1 anecdote. 15 cutoffs (0x2000..0x3C00) x 6 Q values (0.5..10),
    stability = normalized autocorrelation at the saw fundamental's lag
    (375.03 Hz -> lag exactly 256 samples), per Thor's definition --
    atonal roaring scores near zero. Report bench outside make sim;
    prints the r-matrix and per-Q max-stable-fc summaries. Also records
    the B3 note: pitch bend feeds both the pitch bus and the cutoff bus
    (bend+wheel) so filter key tracking follows bends.
    [tb_svf_stability.sv]
2026-08-31 FC_MAX clamp at 15.4 kHz; stability bench becomes a fast corner check
    Thor's call: theory answers what the grid was grinding toward --
    SVF stability needs sin(pi*fc/fs) < Q, and Q below ~0.5 never occurs
    musically, so the ceiling is fs/6 = 16 kHz. FC_MAX = 0x2B80
    (15.36 kHz) in synth_pkg, applied to the effective (base + bus)
    cutoff clamp: no programmable input can destabilize the filter.
    The exhaustive-grid characterization bench is retired (hours of
    runtime, and its Q=0.5 row encoded q1 as 18'h20000 -- NEGATIVE in
    the signed Q2.16 field). Replaced by a fast assert bench in the
    regular suite: worst legal input (cutoff word 0x3FFF, q1 = +max
    = Q 0.5) must stay tonal by the autocorrelation m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
    [element_pipeline.sv, synth_pkg.sv, tb_svf_stability.sv]
2026-08-31 stability clamps final: FC_MAX 0x2B20, Q1_MAX sqrt(2) (Thor's calls)
    Two flat constant clamps, nothing coupled. Butterworth is the
    accepted heaviest damping (Q1_MAX = 0x16A0A); measured at that q1:
    clean through 15.7 kHz, limit-cycling at 16.4 kHz -- FC_MAX = 0x2B20
    (14.4 kHz) is one measured-clean step below the bloom. The high-Q
    end is deliberately unclamped: eff_q1 floors at ZERO, so infinite-Q
    self-oscillation stays reachable as a feature and only nonphysical
    negative damping is excluded. The two-level ceiling and the Q floor
    from the previous revision are removed.
    Corner bench asserts both criteria (r AND un-railed peak -- a limit
    cycle can fake a perfect r) at the two corners that mat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
    [element_pipeline.sv, synth_pkg.sv, tb_svf_stability.sv]
2026-08-31 B3: firmware routes ride the buses -- velocity, wheel, bend
    The bus plan lives in voice_alloc (engine_link stays generic; the
    boot pointer push is 512 ordinary commands, queue deepened to 1024):
    bus 2 global pitch offset -- the pitch wheel
    bus 16+v voice gain offset -- velocity (0.375 dB steps)
    bus 48+v voice cutoff offset -- velocity + wheel + bend, summed
    by firmware (one pointer per sink; the combiner
    producer takes this job at B6)
    Bend now moves BOTH pitch and cutoff buses, so filter key tracking
    follows bends (Thor's B3 note). A bend event is 1 + <=32 bus writes
    instead of 256 OSC-word rewrites; velocity leaves the GAIN word
    entirely (base para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
2026-08-31 tune: playability constants (Thor, by ear)
    Wider cutoff modulation span, base cutoff at +1/2 octave, q1=0.5 (Q=2). Verified playing: no problems even at high pitches with a wide-open filter.
    [voice_alloc.c]
2026-08-31 MILESTONE: B3 verified playing (Thor) -- routes ride the buses
    Velocity into loudness and brightness, bend with filter key
    tracking, wheel on top -- all bus writes, no parameter rewrites
    during play. Thor's tuning captured in the previous commit. Q-loss
    compensation parked in the B6+ list with a measure-first plan.
2026-08-31 B4: producer walker + LFO -- the synth modulates itself
    The idle-slot table executor (bus_architecture.md law 3): 128
    producers x 2 words at 0x0100, banked like parameters (config is
    wiring), walked once per sample at stride 2 (slots 300..~560, 256 of
    ~500 idle slots). Five overlapped stages per entry: config+phase read
    -> decode + phase advance -> waveform (osc_core reused, registered)
    -> the ONE producer multiply (18x18, registered operands, its own
    stage -- law 1) -> saturating base+contribution write.
    The bus model becomes the spec's true form: SPI writes land in a
    dedicated BASE RAM; the walker writes base + contribution into the
    value replicas, so firmware bases and producer modulatio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
2026-08-31 boot vibrato: 1 Hz triangle (Thor -- LFOs are subsonic)
    The audible LFO becomes 1.0 Hz triangle (rate16 = 175), +-19 cents.
    The bench's 93.75 Hz square stays, with a comment explaining it is
    simulation pragmatism (several LFO periods must fit in ~20 ms of
    simulated audio), not a musical opinion.
    [tb_element_program.sv, voice_alloc.c]
2026-08-31 vibrato audible: +-75 cents for ear verification; bench bound honest
    The +-19 cent depth was masked by the +-9 cent unison detune (Thor:
    barely audible). Depth 64 makes the 1 Hz triangle unmistakable for
    the milestone listen; tame afterward. Bench tremolo bound relaxed to
    >2.5x with the window-vs-crest reasoning documented (measured 3.8x,
    dead walker ~1x).
    [tb_element_program.sv, voice_alloc.c]
2026-08-31 MILESTONE: B4 verified by ear (Thor) -- the synth modulates itself
    The 1 Hz triangle vibrato runs with zero SPI traffic: the first
    sound this instrument makes that no processor drives. Spec ladder
    updated.
2026-08-31 B5: ADSR producer + gate-bus triggering -- the clicks die here
    Producer entries grow to 3 words (stride 4, region 0x0100-0x02FF):
    CFG gains a gate-bus field for type 2 (ADSR), RATES packs A/D/R as
    8-bit log2 rates plus the sustain fraction, DEPTH moves to word 2.
    The walker becomes a 3-slot-stride, phase-guarded pipeline (P0..P4)
    serving both types through single address-muxed read registers; the
    ADSR state machine (idle/attack/decay-sustain/release on a 22-bit
    level) is adds/compares/shifts only, outputs use the previous
    sample's state, and the one producer multiply keeps registered
    operands -- the timing rule holds.
    Gate rides a bus, level-sensitive (> 0 = held): note-on and note-off
    are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
2026-08-31 fix: yosys signedness crash + width casts + tb port width
    A $signed() cast directly in the osc_core port connection tripped
    yosys's genrtlil signedness assert -- named intermediate wire. Rate
    decode width casts made explicit; bench pw_addr widened to 9 bits.
    [element_pipeline.sv, tb_element_program.sv]
2026-08-31 fix: producer-table SPI offset -- region base bit 8 broke the slice
    pw_addr = addr[8:0] landed writes 64 entries off (0x0100's bit 8 is
    set); the old 8-bit testbench port truncation was accidentally
    correcting it. Proper region-relative subtract.
    [spi_bus.sv]
2026-08-31 fix: widen the pipeline's pw_addr to 9 bits -- the flat-LFO root cause
    The 8-bit port made the config write index {bank, 8b} while the
    walker reads {bank, entry, word} as 10 bits: mirror-bank writes
    aliased into bank 0's upper entries, bank 1 stayed empty, and after
    a flip the walker read an empty table -- the bus froze at the last
    written value (the bench's flat tremolo at -1024). The ADSR test
    only passed because its last flip left the configured bank active.
    [element_pipeline.sv]
2026-08-31 walker: two stage splits restore the timing margin
    The B5 build closed at 76.37 MHz -- 3.5% margin on a model proven
    optimistic five times. nextpnr's critical path ran from the bus_base
    RAM output through the base+contribution add, the saturation clamps
    and into the replica write ports in one cycle. Splits: the ADSR rate
    decode and gate compare register at P2 (short RAM-output cones,
    state step moves to P3 on registers only), and the saturated sum
    registers at P4 with the replica write at a new P5. Stride and span
    unchanged; the timing rule's spirit -- no RAM output chained through
    heavy logic to a destination in one cycle -- now applied to the
    walker as well.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
    [element_pipeline.sv]
2026-08-31 fix: declaration order (iverilog) + bench tie widths
    The P4 sum wires were declared after their use in the stage block --
    yosys accepted it (build passed) while iverilog refused (suite ran
    empty; the run script's grep also swallowed the error, now widened).
    [element_pipeline.sv, tb_element_pipeline.sv, tb_svf_stability.sv]
2026-08-31 ADSR fixes: A,D,S,R order; sustain in dB; paced bus writes
    Thor's report unpacked into three fixes: (1) RATES now uses the
    universal A, D, S, R order -- the old packing put release third, so
    editing "sustain" changed release (glacial releases = the stuck
    notes' first cause). (2) Sustain documented in his units: one LSB =
    0.375 dB below peak at the 16-octave depth; default now 0xE0 = 12 dB
    below (the old "75%" was 24 dB down -- wrong language, wrong
    default). (3) The engine paces live bus writes 10 us apart: the
    1-deep FPGA mailbox can be overwritten by full-rate SPI bursts, and
    a lost gate write is exactly a stuck note (lost gate-0) or a missing
    note (lost gate-1). Deeper FIFO noted for B6+.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
    [element_pipeline.sv, engine_link.c, engine_link.h, tb_element_program.sv, voice_alloc.c]
2026-08-31 tune: ADSR experiments (Thor, pre-reorder layout)
    Slower attack (0x40) and decay (0x20); the third-byte 0x04 was a sustain attempt that the old field order made a 2.2 s release - the stuck-notes confirmation.
    [voice_alloc.c]
2026-09-01 fix stuck notes for real: mailbox pending-clear bug; 48 dB envelope span
    The true cause (Thor was right that pacing was the wrong fix): the
    mailbox cleared pending on reaching an idle slot while the commit
    additionally required the walker not writing that cycle -- when the
    two coincided (~1 in 3 during the walker span) the write dropped
    silently. Lost gate-off = stuck note; lost gate-on = dead key.
    bus_take is now the single condition for commit and clear. Pacing
    removed: at 10 MHz a word's wire time (5.6 us) exceeds the worst
    commit wait (~3.6 us), so overrun was never physically possible.
    ENV_FLOOR halved to 48 dB: a linear-in-dB attack from -96 dB is
    inaudible most of its ramp (Thor: "de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
    [element_pipeline.sv, engine_link.c, voice_alloc.c]
2026-09-01 docs: attack-curve theory corrected; identifier overhaul parked
    Thor's correction stands in the comment now: the linear level ramp
    into log-encoded gain IS an exponential-amplitude attack (slow-then-
    fast, hence the inaudible start); the future LUT work LINEARIZES the
    attack in amplitude. The roadmap gains the identifier-overhaul rung:
    descriptive names, no letter-jumbles -- effective immediately for
    new code, a zero-behavior sweep later for the existing base.
    [voice_alloc.c]
2026-09-01 tune: wider detune, envelope by ear (Thor)
    Detune spread doubled-plus (+-2..14 LSB); ADSR in the corrected A,D,S,R layout: attack 0x58, very slow decay 0x01, sustain 0xE0, release 0x20 (~0.7 s).
    [voice_alloc.c]
2026-09-01 envelope rates: four-octave down-bias -- gentle decays exist now
    Decay only traverses peak->sustain, a fraction of the level range,
    so unbiased rates made every decay fast (Thor: near useless at high
    sustain, only 0x01 sounded gentle). The rate decode shifts by
    (high4 - 4): full-range times now span ~44 s .. ~0.7 ms for all
    three rates. Firmware defaults carry Thor's feel (+0x40 per rate
    byte), decay dropped into the new gentle zone; bench rates rebased.
    Also: attack-linearization demoted to an open discussion topic (it
    was the agent's idea, not a decision); voice_alloc now logs event-
    bus drops for the mystery-silence hunt (diagnostic fork: console
    still printing note_on during silence = d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
2026-09-01 envelope level gains 4 fractional bits: one uniform log2 rate ladder
    Thor's continuity question exposed the flaw in the conditional-shift
    rate decode: codes with high nibble < 4 truncated, coalescing onto
    repeated values (floating-point denormals) and flattening the bottom
    of the scale. Moving the binary point four bits left IN THE
    ACCUMULATOR instead — ADSR level is now UQ22.4, increments in
    1/16-LSB units — makes the decode a single expression,
    increment = (16+low4) << high4, with all 256 codes distinct
    equal-ratio steps. Perceptually linear per the log-encode/exp-decode
    rule; a MIDI CC maps as (cc << 1). Codes >= 0x40 decode to exactly
    the same speeds as before, so Thor's tuned values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
2026-09-01 voice lifecycle: a voice is a keystroke instance, not a key
    Thor found the allocator's logical fallacy: same MIDI key implied
    recycling the same voice, and note_off marked releasing voices as
    immediately free — so the lowest-index scan kept grabbing the voice
    that had just started its release tail, re-bending one envelope
    instead of layering 32. Now: three states (HELD/RELEASING/IDLE with
    a computed tail deadline, lazily retired), every note-on allocates a
    fresh voice (LRU idle, then most-decayed releasing, then oldest-held
    steal), note_off pairs FIFO with the oldest held instance of the
    key. Releasing tails keep tracking bend/wheel. Lifecycle model
    documented in firmware_architecture.md;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
2026-09-01 docs: MIDI control schema DRAFT for sign-off (CC map, SysEx frame, open questions)
2026-09-02 housekeeping: README rewritten for the current design era; make fw-monitor; build-env tidy-up noted in roadmap; q1 comment matches Thor's tune
2026-09-02 README: drop the process section and tighten the slogan
2026-09-02 log2-encoded resonance: r octaves of Q above Butterworth
    Thor's decision: "Let's break with convention and do log2 encoded
    resonance." FILTER[27:14] becomes r, UQ4.10 octaves of Q above
    Butterworth; gateware decodes q1 = sqrt(2) * 2^-r through a new
    1024x17 q1_lut + barrel shift, riding the exact same stage budget as
    the cutoff-K decode (LUT read into S3, shift in S3, registered at
    S3B) — zero new pipeline stages. The old [0, sqrt2] damping clamp is
    now structural (r = 0 IS Butterworth); at the top of the range the
    shift underflows q1 to zero, so self-oscillation is the natural top
    of scale. The Q bus is taken as-is like pitch/cutoff: one integer =
    one octave of Q ~ +6 dB of resonant peak.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
    [element_pipeline.sv, engine_link.h, synth_pkg.sv, tb_element_program.sv, tb_svf_stability.sv, voice_alloc.c]
2026-09-02 panel slider on GPIO1/ADC1_CH1 -> internal CC71 with NVS-persisted calibration; README wiring tables
2026-09-02 slider: USB-serial-JTAG driver demands buffers > 64 bytes -- use 256 (boot panic fix)
    [slider.c]
2026-09-02 sdkconfig: generated defaults for new ADC/NVS/USB-serial-JTAG components
2026-09-02 slider: 500 Hz single-sample polls with movement hysteresis (Thor: 20 ms x8 averaging was lag for nothing at 7-bit)
2026-09-02 slider: pace polls with esp_timer notify (100 Hz FreeRTOS tick rounds 2 ms to zero -- the engine_link lesson, relearned via task watchdog)
2026-09-02 FreeRTOS tick 1000 Hz; calibration min/max over 8-sample averages + inward margin; hysteresis 1 (Thor, hands-on)
2026-09-02 slider: rolling 8-sample average (500 Hz events, 8 ms group delay) -- measured single-sample noise exceeded the Schmitt band
    [slider.c]
2026-09-02 slider: Thor's CC backlash hysteresis (window of 2, moves in steps of 1) replacing the raw-domain Schmitt
    [slider.c]
2026-09-02 slider: calibration margin span/32 -- end-stop pressure reads ~50 counts beyond resting position, token margin left cc 127 unreachable
2026-09-02 slider: two-point settled calibration (Thor) -- '1'/'2' capture each resting end over 1 s, ends persist independently
2026-09-02 slider: calibration finds the range, period (Thor) -- no margin; round-to-nearest mapping binds rails to settled ends
    [slider.c]
2026-09-02 docs: pll_clk syntax is whole kHz (73728K), -s is load-bearing; park the clock-sanity LED heartbeat
2026-09-03 docs: design.md consolidation part 1 (Thor's cleanup list) -- source/sink terminology settled, CV table and stale planning notes removed, smoothing resolved, CDC trimmed, pin-10 wrong-frequency wordi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
2026-09-03 q1 LUT 1024 -> 16 entries (issue #41): attenuation-grid decode, index r[9:6], BSRAM block reclaimed
    [element_pipeline.sv]
2026-09-03 makefile: pin nextpnr placement seed (SEED ?= 2) -- default seed fails routing after the q1-LUT shrink, seed 2 routes with full margin
2026-09-03 split the mega-bench into four parallel benches + GitHub Actions CI matrix (issue #58); original chain kept as sim-prog-full long-soak
    [tb_prog_boot.sv, tb_prog_bus.sv, tb_prog_sources.sv, tb_prog_sweep.sv]
2026-09-03 sources bench: hard-panned -36 dB preamble gains -- the louder -12 dB pair railed the limiter and flattened the tremolo ratio
2026-09-03 bench family: single source of truth (Thor) -- addresses from synth_pkg, composed field words, named timbre constants; chain rewritten on the common include; fixes two stale old-encoding FILTER words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
    [tb_element_program.sv, tb_prog_boot.sv, tb_prog_bus.sv, tb_prog_sources.sv, tb_prog_sweep.sv]
2026-09-03 gain inversion (issue #40): GAIN words are VOLUME, 0x00 = silence -- one subtract at the effective-parameter seam, positive gain bus = louder, envelope depth positive, p3=0 footgun retired; firmware/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
    [element_pipeline.sv, engine_link.h, tb_element_program.sv, tb_prog_bus.sv, tb_prog_sources.sv, tb_svf_stability.sv, voice_alloc.c]
2026-09-03 fix bench ADSR depth pairing (OFFS_MINUS_2OCT was really -8 oct, misnamed since birth -- renamed, depth now OFFS_PLUS_8OCT); drop numpy from generators (CI PyPI flake, arange -> range, values identic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
    [tb_element_program.sv, tb_prog_bus.sv, tb_prog_sources.sv]
2026-09-03 benches: fix stale -12dB display/comment strings (the drive is -48 dB)
    [tb_element_program.sv, tb_prog_bus.sv]
2026-09-05 ble midi: standard MIDI 1.0 over BLE service on the ESP32-C3
    NimBLE peripheral advertising "Noaidi" with the MIDI service
    (03B80E5A-EDE8-4B33-A751-6CE34EC4C700); a BLE MIDI central (macOS
    Audio MIDI Setup, Android 13+, iOS) can now drive the synth like a
    wired MIDI port. BLE MIDI packets are unpacked in the NimBLE host
    task and fed through the shared midi_parser onto the event bus -
    same path as DIN MIDI from midi_in. Timestamps are discarded (no
    event scheduling yet); running status resets with the connection.
    - ble_midi.c/h: GATT server, packet parse, advertising
    - CMakeLists: bt component (IDF v6: nimble host lives in bt)
    - sdkconfig.defaults: NimBLE peripheral, MTU 517, no bonding
    [ble_midi.c, ble_midi.h, main.c]
2026-09-05 docs: both dev boards are permanently USB-attached to mini-linux
2026-09-05 ble midi: fix boot loop - nimble_port_init before service registration
    Two crashes, both found via the USB-Serial/JTAG console (DTR reset +
    capture, addr2line on the panic dump):
    1. CONFIG_BT_NIMBLE_STATIC_TO_DYNAMIC defaults to y; the GAP service
    defs then reference a heap ctx that is NULL at registration time,
    and ble_gatts_count_cfg walks a NULL+4 pointer (load access fault
    0x4, boot loop). Turned off - static defs, the classic path.
    2. nimble_port_init() is the full bring-up (controller, HCI, NPL
    primitives incl. the host-lock mutex) and must precede
    ble_gatts_add_svcs; ble_hs_lock faulted in xQueueSemaphoreTake
    without it. The bundled bleprph example calls it in app_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
    [ble_midi.c, ble_midi.h, slider.c, slider.h]
2026-09-06 fix #68: hard-mute released voices via GATE-off -- the amp envelope's bus floor never reaches true silence, so 256 elements hum at high volume; firmware retires+mutes finished tails on a 50ms sweep (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
    [voice_alloc.c]
2026-09-06 fix #67: BLE MIDI disconnects (reason 531 = remote terminated) -- add SM config (bonded Just-Works LESC; Apple BLE-MIDI requires encryption), persist bonds in NVS, handle REPEAT_PAIRING by replacing 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
    [ble_midi.c]
2026-09-06 #67: defer conn-param request to post-encryption (in-CONNECT collided, status=554/HCI 0x2A); log the actual negotiated interval+latency+supervision-timeout; bump requested timeout 4s->6s for RF-hiccu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
    [ble_midi.c]
2026-09-06 docs: input transport roles -- wired MIDI plays, BLE for control surfaces (3 bonds, 1 active); both share the event bus (Thor)
2026-09-06 docs: control-map decisions (Thor) -- staged JP-8000-surface-on-Prophet-engine, supersaw 7 elements + osc1 as the 8th, step sequencer, Auto/Internal clock modes; arp/seq MIDI mechanics recorded
2026-09-06 docs: refine (Thor) -- oscillator UNISON as a mode (any waveform; 2-plain/7+1/4+4); cutoff both coarse CC74 + fine CC106 (14-bit); CC1 mod wheel patch-assignable; SysEx grows for the step sequencer
2026-09-06 schema: full CC map to program a basic patch without SysEx (Thor) -- osc/unison/filter/2 envelopes/2 LFOs/arp + standard vol/pan and RPN0 bend range; grouped by section
2026-09-06 #69: render voice programming from active patch_t -- patch.h wired in, patch_default() = former hardcoded timbre (behavior-identical), voice_alloc reads g_patch for waveform/resonance/volume/ADSR ins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
2026-09-06 #70: CC handler -- program a basic patch over MIDI CCs. Live: amp env (73/75/79/72), cutoff (74/106), resonance (71), volume (7), waveform (20), pulse width (25), filter type/dual (29/30), LFO1 rate/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
2026-09-06 #79: BLE MIDI encryption SUPPORTED not REQUIRED -- drop _ENC flags so Android (no pairing) can write; Apple still pairs+encrypts via SM config. Fixes phone connects-but-no-MIDI regression from #67
    [ble_midi.c]
2026-09-06 #70: sustain CC is a LEVEL not a rate -- don't invert CC79/104 (Thor: sustain was upside down); A/D/R stay inverted (up=longer)
    [voice_alloc.c]
2026-09-06 Coalesce live CC edits to stop engine_link watchdog crash (#70)
    Element-word CCs (volume 7, waveform 20, PW 25, filter 29/30) called
    render_active_voices() on every message, and the envelope/cutoff/LFO
    CCs pushed 32 producer/bus writes each. A controller sweep (Thor:
    volume over BLE while playing over wired MIDI) therefore issued
    hundreds of engine_link writes per CC, flooding the command queue and
    event bus (dropped-event warnings) and pinning the engine_link task
    until the task watchdog fired.
    CC handlers now only mutate g_patch and set a dirty bit; a new
    apply_dirty() in the voice_alloc task loop performs the heavy work at
    most every 15 ms (<=66 Hz) regardless of CC rate, so no sweep can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
    [voice_alloc.c]
2026-09-06 Master volume on the gain bus, not element re-renders (#70)
    Thor: setting master volume by re-baking every element GAIN word is
    heavy-handed when that is exactly what the mod buses are for. CC 7 now
    rides the per-voice gain-bus BASE, summed with the amp-envelope
    producer just like the pitch wheel rides the pitch bus: <=32 cheap bus
    writes, no swap, no element rewrite.
    The split is behaviour-identical. The RTL adds (gain_bus >>> 6) to the
    UQ4.4 GAIN-word code, so 64 bus LSB = one gain step. The GAIN word now
    carries a fixed per-note ceiling (VOL_REF - velocity) and the base
    carries off = (volume - VOL_REF)*64; off>>6 = volume-VOL_REF, so
    word+bus == the old (volume - velocity) code bit-for-b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
    [voice_alloc.c]
2026-09-06 CC 29 filter type: map to the 3 real types, not 4 (#70)
    The RTL SVF (element_pipeline.sv S6/S9) has three filter types: 0=LP,
    1=BP, 2=HP, with any other code falling into the LP default. The CC
    handler mapped (val>>5)&3 to four codes, so code 3 (top of travel)
    was a second LP identical to code 0 (Thor: final type sounded
    identical to the first). Map (val*3)>>7 to 0..2 so the full sweep is
    LP to BP to HP.
    Docs: record that the filter has 3 types; that CC 25 duty affects the
    pulse wave only (osc_core: saw/tri/sine ignore it) with parabola skew
    deferred to #66; and that waveform 3 is the rough parabolic-sine
    (true sine #65, noise #64) that read as a noisy tone.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
    [voice_alloc.c]
2026-09-06 CC 25 pulse duty: zero the null buses so duty is not swamped (#70)
    Thor: pulse-width (CC 25) has no audible effect. The oscillator core
    is correct -- the new tb_osc_core proves the pulse high-fraction
    tracks duty perfectly in simulation. The fault is upstream: the duty
    modulation pointer (PTRS0[19:10], set by wire_pointers) targets bus 0,
    the intended "null" bus, and firmware never writes bus 0. Unwritten
    bus BSRAM is not guaranteed zero on the GW2AR -- which is exactly why
    the pitch and reso buses are already written to 0 explicitly at init.
    So on hardware eff_duty = duty_word + (garbage << 13) saturates to a
    rail and the pulse width is stuck regardless of CC 25.
    Establish the null-bus inv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
    [voice_alloc.c]
2026-09-06 rtl: add tb_osc_core, the missing oscillator bench (#70)
    The oscillator core had no unit bench, so the waveform ear-bugs shipped
    untested. This drives a phase accumulator into osc_core the way the
    pipeline does and asserts each waveform's shape plus that the pulse
    high-fraction tracks duty (lo/mid/hi = 8/32/56 of 64). It PASSES,
    which proves the parabolic sine and the pulse duty are functionally
    correct in isolation -- the hardware reports (wave 3 "noisy", duty
    "does nothing") are upstream: duty is the null-bus fix; wave 3's
    hardware noise is a synthesis/timing question for osc_core's 23x24
    combinational multiply, tracked separately. Wired into `make sim`.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
    [tb_osc_core.sv]
2026-09-06 osc_core: true sine from a quarter-wave LUT (#65)
    Thor: waveform 3 read as a noisy tone on hardware. The core was a
    parabolic approximation (y = 4x(1-x)) via a 23x24 combinational
    multiply -- correct in sim but suspect in synthesis, and ~6 dB low.
    Replace it with a real sine: a 256-entry quarter-wave LUT (Q0.24
    magnitude), full cycle rebuilt from phase[23:22] -- quadrant[0]
    mirrors the falling quarters, quadrant[1] negates the lower half.
    Full-scale like saw/tri; deletes the big multiply from the S3 cone.
    tb_osc_core updated to assert the true-sine cardinals (0 / +peak /
    0 / -peak at 0, 1/4, 1/2, 3/4) and passes. gen_sine_lut.py + Makefile
    LUT wiring alongside the existing phase/k/q1/att ge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
    [osc_core.sv, tb_osc_core.sv]
2026-09-06 Two oscillators + voice structures rendered (#72)
    Thor: only one oscillator's waveform/duty was reaching the engine.
    voice_program rendered all 8 elements from osc[0] with a fixed detune
    table; osc[1], voice_struct, coarse/fine, unison spread and mix were
    in patch.h but nothing rendered them.
    Now build_voicing() maps the 8 elements onto the two oscillators per
    voice_struct, and voice_program applies each oscillator's own wave,
    duty and pitch (note + coarse semitones + fine detune + unison
    spread):
    - 2-plain : osc1 + osc2, centred, 6 elements muted (the new default)
    - 7+1 : 7-way detuned supersaw (osc1) + osc2 plain
    - 4+4 : both oscillators, 4-way detuned each
    Inactive elements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
    [patch.c, patch.h, voice_alloc.c]
2026-09-06 LFO 1 rate: exponential (log2) map with a subsonic floor (#70)
    Thor: the LFO range does not go low enough and is useless past ~CC 40.
    The gateware LFO increment is LINEAR in frequency (freq = inc*Fs/2^24,
    Fs=96 kHz), and CC 76 mapped to it linearly (val<<7) -- so the useful
    slow range was crammed into the bottom few values and the top was all
    uselessly-fast rates.
    Map CC 76 exponentially instead (lfo_rate_from_cc): ~0.03 Hz .. ~30 Hz
    across the CC, one equal frequency RATIO per step -- ~1 Hz sits near
    the middle, deep sub-Hz sweeps at the bottom. LFO depth (CC 77)
    unchanged (Thor: level is fine).
2026-09-07 test: BLE-MIDI stress harness + crash backtraces (#70)
    Thor: stop guessing at the engine_link watchdog crash -- enable full
    backtraces and stress it automatically. Two parts:
    - sdkconfig.defaults: CONFIG_ESP_SYSTEM_USE_FRAME_POINTER=y (RISC-V
    backtraces need frame pointers) and CONFIG_ESP_TASK_WDT_PANIC=y so
    the task watchdog gives a clean panic + stack dump of the stuck task
    instead of warning and limping on. (Debug aids; revisit before
    release.)
    - tools/ble_midi_fuzz.py: connects to the Noaidi over BLE from the
    Linux host and floods it with CC sweeps (voice mode / volume / mix)
    interleaved with note on/off -- exactly the "adjust over Bluetooth
    while playing" that crashes it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
    [ble_midi_fuzz.py]
2026-09-07 test: on-target MIDI stress injector (Kconfig-gated) (#70)
    BLE pairing from the Linux host is fighting BlueZ, and the crash lives
    in the voice_alloc -> engine_link path regardless of the CC source, so
    add a deterministic on-target repro that needs no external controller.
    stress_test.c publishes CC 26/7/24 sweeps + note on/off straight onto
    the event bus (the same path midi_in/ble_midi feed) at a heavy MIDI
    rate for 60 s. Gated by CONFIG_NOAIDI_STRESS_TEST (default n, via
    main/Kconfig.projbuild) so normal firmware is unaffected. With
    FRAME_POINTER + TASK_WDT_PANIC (previous commit) a load crash now
    yields a clean panic + backtrace on the serial at boot.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
    [main.c, stress_test.c, stress_test.h]
2026-09-07 Fix engine_link watchdog under CC load: burst SPI + skip tails (#70)
    Root cause, from the decoded backtrace under the new stress injector:
    engine_task was doing ONE full ESP-IDF SPI-master transaction per
    32-bit word (fpga_word_write -> spi_device_transmit -> bus lock / ISR /
    semaphore). The driver cost is per-transaction, so a CC that re-rendered
    every voice issued hundreds of transactions and pinned engine_link on
    CPU 0 until the task watchdog starved IDLE and aborted.
    Two fixes:
    - engine_link: burst the whole 7-word element row in ONE transaction
    whenever any of its words changed (the SPI layer already supports
    auto-increment bursts; untouched words are current in s_image so
    re-sen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
    [engine_link.c, voice_alloc.c]
2026-09-07 engine_link SPI: polling transmit, not the interrupt path (#70)
    The task-watchdog backtrace showed engine_link pinned in the ESP-IDF SPI-master interrupt path (spi_bus_lock_bg_request -> esp_intr_enable -> semaphore) -- heavy per-transaction overhead. engine_link is the sole SPI owner sending tiny frequent frames, so switch fpga_xfer_bytes to spi_device_polling_transmit, which busy-waits the few us of wire time without the ISR/queue machinery.
2026-09-07 voice_alloc: yield to IDLE under sustained flood (single-core) (#70)
    The ESP32-C3 is single-core; under a sustained CC/note flood the voice_alloc queue never empties, so xQueueReceive never blocks and IDLE (prio 0) is starved -> task watchdog (seen catching engine_link/esp_timer/voice_alloc interchangeably). Force a vTaskDelay(1) if the loop has run >2ms without blocking. Free in normal use (queue empties, we block naturally); under flood it caps CPU share and the event bus drops the excess -- correct single-core backpressure.
    [voice_alloc.c]
2026-09-07 engine_link: yield to IDLE after long wakes (single-core) (#70)
    Companion to the voice_alloc yield: if a wake burst a flood of dirty rows over SPI and ran long, the pending 1 kHz notify meant engine_task never blocked, starving IDLE. Yield a tick after wakes over ~800 us. Together the two yields guarantee IDLE is scheduled under any MIDI flood -- excess is dropped, not crashed.
    [engine_link.c]
2026-09-07 test: pace stress injector to a realistic rate (~2000 msg/s) (#70)
    The burst=8 x 4 msgs at the 1 kHz tick was 32000 msg/s -- ~32x wired-MIDI saturation, beyond the SPI's physical throughput. Pace to ~2000 msg/s (2x MIDI), a firm but realistic worst case.
2026-09-07 midi_log: yield to IDLE under sustained flood (single-core) (#70)
    Third of the single-core guards: midi_log printf's every event at prio 4; under a MIDI flood its queue never empties so it never blocks, starving IDLE. Yield a tick after 2 ms of unbroken printing; the event bus drops the excess (already counted).
2026-09-07 CC 22 osc2 coarse: +/-12 semitones, not +/-63 (#72)
    Thor: coarse detune far too sensitive for hand-tuning a pitch. +/-12 semitones gives ~5 CC steps per semitone; cents live on CC 23 fine.
2026-09-07 docs: roadmap rungs 12/13 -- firmware test suite (#80), audio capture chain (#81)
2026-09-07 MOD envelope, LFO 2, RPN 0 bend range (#42, #73, #74)
    Three modulation subtasks from the VA tracker (#77), all firmware-only
    (the walker's 128 producer slots had room):
    MOD envelope (#42): ADSR producers 64..95, one per voice, watching the
    voice's gate bus and driving its CUTOFF bus -- the classic filter
    envelope. Rates on CCs 102-105 (already stored, now live), depth CC
    107 BIPOLAR (centre off, +/-4 octaves full travel; the walker DEPTH
    word is signed 18-bit), destination CC 108 stored with cutoff
    implemented. Default depth 0 -- boot timbre unchanged.
    LFO 2 (#73): producer slot 1, global. CC 109 rate (same exponential
    0.03-30 Hz map), 110 depth (per-dest scale), 111 shape, 112
    destination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
2026-09-07 ble_midi: TEMP access-trace log for fuzzer write rejection (#82)
2026-09-07 BLE ingress decoupled from NimBLE host task; ALSA-path fuzzer (#83, #82, #80)
    The new BLE MIDI stress suite found a fresh crash on its first run:
    40 s of ~1000 msg/s over real BLE -> task watchdog at ~19 s, IDLE
    starved, btController running. Cause: ble_midi parsed packets and
    published to the event bus INSIDE the NimBLE host task; with
    btController none of the #70 yield guards applied and the single core
    saturated.
    Fix: the GATT access callback now only copies the packet into a
    NOSPLIT ring buffer; a new ble_rx task (prio 4) drains it, strips the
    BLE-MIDI framing, feeds the shared parser and publishes -- with the
    same 2 ms single-core yield guard as the other hot tasks. Ring-full
    drops are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
    [ble_midi.c, ble_midi_fuzz.py]
2026-09-07 AGENTS.md: ble_midi threading section reflects the ble_rx decoupling (#83)
2026-09-07 tools: live capture-level meter for the audio chain (#81)
    Noaidi -> Focusrite -> ICUSBAUDIO7D line-in -> ALSA. Prints a live peak-dBFS bar (optionally holding a BLE-MIDI test chord) so the two gain stages -- Focusrite output and ALSA capture -- get set against a reference tone instead of guesswork. Warns above -1 dBFS and below -30.
2026-09-07 CC 120/123 panic: all-sound-off / all-notes-off (#70 schema row, found via fuzzer stuck notes)
    The BLE stress suite ends with CC 123, which was a schema row but not implemented -- note-offs dropped under flood backpressure left voices ringing forever (Thor heard them). 123 releases every held voice through the normal release path; 120 hard-mutes everything immediately.
    [voice_alloc.c]
2026-09-07 Gateware test tone + audio purity check (#81)
    Full-scale 187.5 Hz sine (512-sample period at 96 kHz, sine-LUT reuse, ~0 dBFS) muxed over both outputs, enabled via bus-1023 control latch; firmware maps CC 119 so the test suite switches it over BLE MIDI with no console. tools/audio_purity_check.py: coherent 1024-pt FFT at 48 kHz (tone on bin 4 exactly), Thor's criterion -- any harmonic above 1/4096 of the fundamental (-72.2 dBc, the 12-bit audibility line) fails. This is the self-check for whether further analog gain-staging work is needed.
    [audio_purity_check.py, element_pipeline.sv, top.sv, voice_alloc.c]
2026-09-07 test tone: 1500 Hz midband, not 187.5 Hz (#81)
    Thor: coupling caps along the 10 m analog chain attenuate low tones; aim midband. 1500 Hz is the coherent sweet spot: 64-sample period at 96 kHz (phase step 2^18 exactly), bin 32 of a 1024-pt FFT at 48 kHz, harmonics H2-H15 on exact bins below Nyquist.
2026-09-07 reconnect test: serial dump on failed cycles, btctl log, --gap (#78)
    [ble_reconnect_test.py]
2026-09-07 reconnect test: wait for real link teardown between cycles (#78)
    The alternating failures were a harness race, not firmware: BlueZ's disconnect is async, and a connect issued before teardown completes gets 'Connection successful' for the DYING link, which the finishing disconnect then kills -- the exact first-reconnect symptom, reproduced client-side. Wait for bluetoothctl 'Connected: no' instead of the ALSA port vanishing.
    [ble_reconnect_test.py]
2026-09-07 tools: resonance clip-onset sweep (#63)
    Plays a sustained note over BLE, steps CC 71, captures 1 s per step, reports peak/RMS/crest. RTL theory: sat_q216 clamps the filter outputs at +/-2.0 UPSTREAM of the S10 gain multiply while the osc drives the filter at a fixed clamp-12 dB -- predicting clip onset near r=2 octaves (CC71~16) at any volume. This measures the actual knee.
    [reso_clip_sweep.py]
2026-09-07 sine LUT: half-sample offset -- fixes -54 dBc H3 the purity check caught (#81, #65)
    The quarter-wave mirror uses ones-complement (~i = 255-i), whose exact reflection point requires the table sampled at (i+0.5)/256 -- the classic quarter-wave-table trick. Without it the falling quarters are phase-shifted 1/1024 cycle, breaking quarter symmetry: odd harmonics H3 -54 dBc, H5/H7 -64. A bit-exact model of the reconstruction matches the hardware capture to 0.2 dB across three harmonics; with the offset the worst harmonic is -105.6 dBc. One generator line; no RTL change. Also cleans the musical sine (waveform 3) and the walker LFO shapes.
2026-09-07 docs: roadmap rung 14 -- sampled/tracker sound (#85); rung 13 marked done
2026-09-07 Output tilt: one-pole 6 dB/oct lowpass on the mix (Thor, by ear)
    out += (in - out) >>> 4 per channel at sample rate -- alpha 1/16 at 96 kHz, corner ~950 Hz, the gentle analog-style top-end tilt Thor asked for mid-ear-test. 26-bit intermediates (a 24-24 difference needs 25 bits; the convex result always fits 24). Sits BEFORE the test-tone mux so the purity reference stays unfiltered.
2026-09-07 tools: output-tilt verification via harmonic-envelope fit
    Plays a saw with the SVF at its clamp, captures, divides out the ideal 1/n saw spectrum and least-squares-fits the residual one-pole corner. Expected fc ~986 Hz for alpha=1/16 at 96 kHz. The test tone bypasses the tilt by design, so this drives the mix path.
2026-09-08 AGENTS: Focusrite must clock-slave to S/PDIF; reboot reverts USB mixer (#86)
    Two bench gremlins root-caused by measurement: (1) the interface on internal clock free-runs ~6 ppm off the FPGA stream and its receive FIFO recenters every ~1.65 s -- an 8 ms glitch burst heard as periodic clicking; 73 bursts/120 s -> 0 after slaving the clock to S/PDIF. (2) A dev-host reboot reverts the USB capture mixer to Mic at +11 dB (loud 100 Hz buzz); capture scripts must assert source=Line first.
2026-09-08 Bus summing by default: consecutive same-bus sources sum (#84)
    Law 1 says buses are summing nodes; the walker now delivers it as
    DEFAULT behaviour with no flags (Thor: "why a CFG flag for expected
    default behaviour?"). At the moment an entry's sum is computed, the
    walker's write-back registers still hold the previous entry's result;
    a target-bus comparator selects it as the addend instead of the
    firmware base. One comparator + one mux + one uncleaned copy of the
    write-valid bit -- zero new RAM, pipeline untouched, timing cone shape
    unchanged (RAM-out -> add -> clamp -> register, one compare wider).
    Allocator rule (documented in bus_architecture.md as law 3's
    companion): group same-bus sourc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
2026-09-08 Audio repoint Q2.16 -> Q4.14: +12 dB resonance headroom (#63)
    Thor's fix for resonance clipping, measured onset CC71~32 at any volume because the filter-output clamp sat pre-gain at +/-2.0 with the osc driving at clamp-12 dB. The 18-bit audio path repoints to Q4.14: sat shifts 12->14 (clamp now +/-8.0), SVF2 input alignment 12->14, mix conversion 8->10 (sat24 input widened to 36 bits). Osc drive and SVF state magnitudes unchanged (S4 alignment stays <<<12), so zero-resonance loudness and stability margins are IDENTICAL -- the -2 bits of audio scale cancel the +2 bits of mix shift. Cost: 14 fraction bits ~ 86 dB per-element SNR, below the analog floor. Expected measured clip onset moves to CC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
    [element_pipeline.sv, tb_element_pipeline.sv]
2026-09-08 Default voice: 7+1 supersaw + sine sub, 24 dB, widened mod-wheel sweep
    New patch_default() (Thor, 2026-09-08): 7-voice supersaw (osc1) plus a
    pure sine one octave below (osc2) through a 24 dB/oct lowpass. The sine
    sub fattens the saws without muddying the midrange.
    Sweep widened for mod-wheel control: CC 74 now spans +/-4 octaves (was
    +/-2, apply_cutoff >>1), and the mod wheel opens ~+5 octaves (was ~+3,
    cut_bus_value *40). The wheel is Thor's primary sweep control.
    Rename WAVE_PARABOLIC -> WAVE_SINE (idx 3 already renders the true sine
    LUT since #65). Record the default-voice decision in design.md.
2026-09-08 Output tilt corner 950 Hz -> 4.4 kHz (>>>4 -> >>>2)
    Thor 2026-09-08: the >>>4 tilt was too aggressive - a ~950 Hz corner
    rolled off the whole presence band and muffled the supersaw. alpha=1/4
    puts the 6 dB/oct corner at ~4.4 kHz: still smooths the digital top
    end, keeps the shimmer. Record the tilt in design.md Outputs.
2026-09-08 sdkconfig: regenerate (WDT panic + frame-pointer debug defaults, stress-test menu)
2026-09-09 Default patch: MOD envelope on, sent to cutoff (#87) + boot banner
    Thor 2026-09-09 (#87): the default patch gets a MOD envelope with the
    same initial params as the AMP envelope (copied, so they stay in step),
    sent to the cutoff bus at +2 octaves (CC 107 ~ 96). The filter contour
    tracks the loudness contour.
    Boot banner: print esp_app_desc version + build date/time first thing
    in app_main. A hash-verified flash once left the old app running (C3
    USB-JTAG hard-reset quirk); the banner is the ground truth for which
    build is live.
    [main.c, patch.c]
2026-09-09 Measurement tools: remove DC offset before analysis (#81)
    Thor recalibrated the analog capture path (Line 0% / -16 dB, Focusrite
    output hand-tuned, saved via alsactl store) and found a significant DC
    offset in the recorded signal. All four analysis tools now subtract the
    mean before computing peak/RMS/FFT; the level meter also reports the
    worst block DC it saw. AGENTS.md records the new calibration and that
    the USB interface clips well before 0 dBFS.
2026-09-09 Console logger: always-on witness for panic reboots
    Thor lost the sound mid-play testing the MOD envelope; with WDT panic
    now enabled a starved task reboots the chip (engine mutes on boot =
    exactly that symptom) and prints a decoded backtrace - but nothing was
    listening. tools/console_logger.sh holds ttyACM0 when no monitor is
    open and appends timestamped lines to /tmp/noaidi_console.log,
    surviving reflash port drops. AGENTS.md documents it.
2026-09-09 design: modulation authority rule, velocity routing, dev control surface
    Thor 2026-09-09, approved: (1) any pitch/cutoff modulation amount must
    span the destination rail to rail (CC 107 to be widened from +/-4 oct
    to full authority; clamp saturation makes over-authority safe);
    (2) velocity becomes a source with per-destination sensitivity amounts,
    defaults = today, zero = off; velocity scales MOD-env depth
    multiplicatively (synth convention); (3) Open Stage Control browser
    panel as the dev-time control surface, panel file doubling as living
    CC-schema documentation. Transport for the panel under discussion.
2026-09-10 Tilt to >>>3 (~2 kHz, by ear); console wholly to USB-Serial/JTAG
    Thor 2026-09-09/10: output tilt settled at alpha=1/8 after trying
    >>>4 (too dark) and >>>2 (too bright). Console moved off UART0 to the
    USB-Serial/JTAG controller (ESP_CONSOLE_UART_NUM=-1), freeing UART0
    for the panel MIDI port (#90); a second MIDI-IN circuit is soldered
    to GPIO2, fed from the dev host via a CH345 USB-MIDI adapter.
2026-09-10 Panel MIDI in: UART0 RX on GPIO2, Open Stage Control exclusive (#90)
    Second wired MIDI ingress for the dev-host panel: midi_in.c refactored
    to a per-port context (each stream gets its own parser - running
    status is per-stream), midi_panel_init(2) brings up UART0 on GPIO2 at
    31250 baud, publishing to the same event bus as DIN and BLE. Possible
    because Thor moved the console wholly to USB-Serial/JTAG and soldered
    the MIDI-IN circuit to GPIO2 (fed by a CH345 USB-MIDI adapter). The
    port is reserved for Open Stage Control - test scripts stay on
    BLE/DIN, so panel and test traffic never contend.
    Also: top.sv tilt comment brought in line with Thor's >>>3 retune;
    design.md (tilt final, transport res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
2026-09-10 Panel MIDI bring-up diagnostics: idle-polarity preflight + first-bytes log
    First CH345 test delivered zero bytes to GPIO2 (amidi sends fine
    host-side). To tell wired-but-inverted/garbled from nothing-arrives
    without a scope: sample the RX pin idle level before the UART claims
    it (standard opto MIDI-IN idles high; low = inverting stage or wiring
    fault - enable RXD inversion and warn loudly), and hex-log the first
    8 bytes each port ever receives.
    [midi_in.c]
2026-09-10 Open Stage Control panel: session generator + headless launcher (#90)
    The panel IS the CC map rendered as knobs: gen_panel.py emits
    noaidi-panel.json from a table mirroring docs/midi_schema.md (39
    widgets - osc/filter/env/LFO/global sections plus a test keyboard),
    defaults mirroring patch_default() so it opens showing the boot patch.
    run.sh serves it headless (ELECTRON_RUN_AS_NODE - the .deb Electron
    needs X otherwise) on :8080, discovering the CH345 port indices from
    o-s-c own listing. One instance may hold the CH345 at a time.
2026-09-10 osc_panel: visible section headers + descriptive single-line labels
    Thor: knobs had no usable labels. Root causes: panel widgets do not
    render their label property (headers were invisible) and the newline
    in knob labels rendered poorly. Sections now carry explicit text-
    widget headers (fixed 26px, expand:true rows below); every control is
    labeled Name (CC) on one line with plainer names (Vibrato Depth,
    Env>Cutoff, Wheel>Cutoff, Pulse Width, Unison Spread).
2026-09-10 osc_panel: per-control text captions with live value readout
    Measured on Thor's screen: v1.31 renders labels for buttons and text
    widgets but NOT for knobs/faders/switches. Stop fighting it - every
    control is wrapped in a mini vertical panel with an explicit text
    caption underneath (Name (CC): live value via the @{ccNN} dynamic
    reference), so label-to-control pairing is structural.
2026-09-10 osc_panel: volume/wheel as knobs, drop the dead Env Dest control
    Thor panel shakedown: vertical faders nearly unusable - Global row is
    all round knobs now. CC 108 removed from the panel (stored-only in
    firmware, cutoff is the sole MOD-env destination; a knob that does
    nothing erodes trust in the panel).
2026-09-10 docs: scope ladder terminology - Global / Channel / Voice
    Thor 2026-09-10, used consistently from now on: Global fans out to
    all channels, Channel to all voices on one channel, Voice to all
    elements on one voice. Each channel is its own little synth sharing
    resources. Nothing in the current bus fabric is Global by intent -
    buses historically called global (resonance, duty, bend) are Channel
    buses coinciding with global scope only while one channel exists.
2026-09-10 Shakedown round 1: balance mute, pan, key track, OSC2 PW, CC107 authority (#91)
    From Thor's first Open Stage Control session:
    - CC 24 balance at the rails now hard-mutes the disfavored oscillator
    (the log-gain mix term alone tops out at ~23.6 dB - audible leak).
    - CC 10 pan implemented: per-side log-gain attenuation baked into the
    element L/R GAIN words, full deflection mutes the far side.
    - CC 31 key tracking implemented: 127 = the historical hardwired 100%
    tracking (default), 0 = cutoff fixed at the C4 reference.
    - CC 85 = osc 2 pulse width (CC 25 stays osc 1).
    - CC 107 widened <<6 -> <<8: +-16 octaves rail-to-rail (#88 authority
    rule); panel default corrected to 72 = boot +2 oct.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
    [patch.c, voice_alloc.c]
2026-09-10 tools: shakedown_check - BLE-driven #91 verification with measured pan
    Runs before the ear pass (Thor rule): CC 10/31/85/107 ingress smoke
    via the BLE test transport (panel port stays Open Stage Control
    exclusive), console watched for echoes and crash keys, and pan
    MEASURED on the analog capture chain - stereo RMS (DC-removed, #81)
    at pan 0/64/127; >=15 dB toward the panned side at the rails, <=3 dB
    imbalance at center. Reuses ble_midi_fuzz helpers incl. the
    disconnect+untrust discipline.
    [shakedown_check.py]
2026-09-10 shakedown_check: hard-mute between pan steps, ignore benign boot reset
    First run diagnosed its own two failures: the multi-second amp release
    tail bled the previous center-pan note into the next capture (fix:
    CC 120 hard mute between steps - also exercises the panic path), and
    the capture reset boot banner (rst:0x15 USB_UART_CHIP_RESET) tripped
    the crash filter (fix: benign reset reasons excluded).
    [shakedown_check.py]
2026-09-10 Shakedown round 2: OSC1 pitch/fine, fine = +-0.5 semi, CC74 full authority
    Thor 2026-09-10 panel session:
    - CC 14/15 = OSC1 pitch/fine (same mappings as osc2); CC 22 whole-
    semitone steps confirmed; fine (15/23) full travel now +-0.5
    semitone (was +-1.5), center 64.
    - CC 74 span widened to +-8 octaves around the key-tracked base
    (authority rule #88): full deflection reaches the closed rail -
    Thor could not dial cutoff to 0 at +-4.
    - Panel: OSC1 gains Pitch/Fine; all pitch/fine knobs default 64 =
    center so double-tap returns to unison (osc2 boots at -12, dial
    reads center until touched - Thor prefers the double-tap home);
    mod-wheel knob removed (physical keyboard has it; wheel->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
2026-09-10 Panel: drop virtual keyboard; console logger goes polite
    Thor: the physical keyboard covers notes/velocity/wheels - the panel
    exists for the MIDI it cannot send, and the on-screen keys just cost
    space. Console logger rewritten in polite mode after its 2s reconnect
    loop raced esptool: attaches only when the ESP port is free, backs
    off for flashes/monitors, re-attaches by itself, discovers the port
    by vendor. Thor follows it with tail -f /tmp/noaidi_console.log
    instead of running a monitor. AGENTS updated.
2026-09-10 docs: parameter-mapping conventions audit (DRAFT for Thor)
    Research vs the named inspirations (Nord Lead, JP-8000, Prophet,
    EMU10K1): our log2-everything encoding IS the SoundFont/EMU10K1 model
    (timecents / centibels / cents), so most deviations are mapping
    choices, not architecture. Findings: F1 attack segment linear-in-dB
    where convention is linear-in-amplitude (SF2 spec) - the likely main
    feel bug, small gateware fix (RC step toward peak in the attack
    branch); F2 PW rails reach silent 0/100%; F3 vibrato depth max +-6
    semi is neither fine vibrato nor full FX; F5 resonance taper onset
    placement unmeasured. Decay/release, rates ladder, cutoff, gain,
    pan, LFO rate law all confirmed convention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
2026-09-10 Cutoff feel: square-law env depth taper, key track 0-200% (#94)
    Thor: MOD env -> cutoff overly sensitive (linear over +-16 oct = 3
    semitones per CC click), key track undersensitive (capped at 100%).
    CC 107 now square-law bipolar - d*|d|*4: ~+-1 oct at quarter turn,
    +-4 at half, +-16 at the rails, so fine control near centre and full
    authority (#88) at the ends. CC 31 rescaled to 0..200% with CENTER
    64 = 100% = the historical tracking (default; overtracking above
    centre per convention). Panel defaults follow (Env>Cutoff 87 ~ boot
    +2 oct, Key Track 64 bipolar); schema rows updated.
2026-09-10 shakedown_check: pause/restart the console logger around the run
    The now-permanent polite logger holds the ESP port; the check needs
    it for its own capture. Pause at start, hand back at exit - same
    contract as the deploy flow.
2026-09-10 Velocity sensitivity: CC 86 vel->amp, CC 87 vel->cutoff, 0 = OFF (#89)
    Thor: hardcoded velocity made key track impossible to judge - and the
    cutoff term turns out to be vel*48 = up to +6 OCTAVES of brightening,
    not the small darkening the docs remembered. Both sends now have
    sensitivity parameters: 64 = the exact historical feel (bit-for-bit),
    127 ~ double, 0 = velocity OFF for isolation testing. Read at
    note-on; held notes keep their terms until re-struck. Panel gains
    Vel>Amp / Vel>Cutoff knobs; schema rows added; param_conventions.md
    EMU10K1 framing corrected (DSP inspiration; SoundFont is Creative -
    consulted only as a rare WRITTEN spec of these mappings).
    Remaining on #89: velocity scal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
    [patch.c, patch.h, voice_alloc.c]
2026-09-10 docs: SF-player-behavior principle; F1 deferred with scoping refinement
    Thor 2026-09-10: for run-of-the-mill behavior, act like a SoundFont
    player where applicable - it will not surprise anybody; VA practice
    wins on divergence. F1 (attack curve) deferred - and scoped tighter:
    SF2 modulation-envelope stages are linear-in-cents, which our MOD env
    already is natively on the log cutoff bus; the deviation is the AMP
    attack only.
2026-09-10 tools: filter_pain_check - measure the high-resonance BRRR (#43)
    Thor found the post-Q4.14 instability edge by ear: stable to reso ~35
    at 24 dB/oct, ~70 at 12 dB/oct, with a repro recipe that pins the
    corner ~1 octave below the fundamental (cutoff 52 + 100% key track,
    velocity and MOD env off). This sweeps CC 71 at both slopes with his
    exact patch and measures peak/RMS/crest plus a FLAT-TOP fraction
    (share of samples within 2% of the capture peak - hard saturation
    parks the waveform at the rails and the fraction jumps).
2026-09-10 tools: pain_capture - listenable examples of the filter pain zones (#43)
2026-09-10 filter_pain_check: cutoff override arg - probe the bright corner
    Thor: the physical slider on the (bright) default patch could near-
    max resonance with only glassiness. Hypothesis: SVF stress is the
    low-cutoff/high-Q corner (states ~1/K balloon into the clamps);
    bright fc keeps states small. cutoff_cc argv decides it empirically.
2026-09-10 Pulse width: unipolar log taper, 50% to 5% (#94 F2)
    Thor: the bipolar halves sound identical (duty d and 1-d = same
    spectrum inverted) and the effect is dramatic near the rails - so the
    range is now unipolar with EQUAL-RATIO duty steps: 0 = square, 127 =
    5% pulse, duty = 0.5*10^(-val/127). Fine resolution at the thin end,
    the degenerate silent 0/100% unreachable. Panel PW knobs unipolar,
    default 0. AGENTS notes the ~0.5 dB center-pan chain imbalance as a
    known artifact (like the DC offset - not a synth bug).
    [voice_alloc.c]
2026-09-10 Bus as source: walker type 3 reads another bus (#44)
    Thor's reframing collapsed the combiner concept: a bus is already a
    combiner of sources - the only new thing needed is other-bus-as-a-
    source. Type 3 is stateless: CFG[25:16] names the SOURCE bus (the
    ADSR gate-bus field, so the P1 read path is untouched), the value
    read multiplies by DEPTH (0x10000 = unity, sign inverts) and
    chain-adds to the target. Reads see earlier-in-table writes this
    sample - ordered routes stay zero-lag; C = A*x + B*y is two entries
    in adjacent slots (#84). Three-line datapath change: valid gating,
    source mux input, nothing else - state writeback was already gated
    to types 1/2.
    Bench: tb_prog_sources gains the case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
    [element_pipeline.sv, tb_prog_sources.sv]
2026-09-10 Channel cutoff bus: type-3 fan-out in real use + hardware test (#44)
    Thor: untested new features are never completed, and completing #44
    means using it for the channel->voice->element branching. Done:
    - BUS_CH_CUT (bus 4): wheel + bend + CC74/106 are ONE channel-bus
    write now; 32 stateless type-3 entries fan it to the per-voice
    cutoff buses. Per-voice base carries only velocity.
    - Producer relayout: 64..127 = per-voice PAIRS (MOD env even slot,
    fan-out odd slot) - both write BUS_CUT(v) and #84 chain summing
    requires adjacency. PROD_MODENV/PROD_FANOUT macros; all writers
    follow.
    - Docs corrected: the type-3 read is of the source bus FIRMWARE base
    (walker contributions live only i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
    [bus_source_check.py, element_pipeline.sv, voice_alloc.c]
2026-09-10 bus_source_check: tonal operating points, level-delta assert
    First run judged wrongly: dark=10 closed the filter ~7 oct down to
    the chain floor, and a noise capture scores HIGH on the diff-RMS
    brightness index, inverting the comparison. (The silence itself
    already proved cutoff responds through the new path - CC 74 has no
    other route.) Now dark=52 / bright=100, both tonal; asserts: both
    above floor, bright >= dark+12 dB, brightness ratio >= 1.5.
    [bus_source_check.py]
2026-09-10 bus_source_check: note 57 - 110 Hz fundamental sank into chain LF rolloff
2026-09-10 tb_prog_sources: firmware-shaped triple chain with exact replica assert (#44)
2026-09-10 bus_source_check: self-contained asserts - the sim holds the exact proof
    Absolute anchors from other patches misled two runs. Hardware asserts
    now: bright tonal (> -60 dBFS) and bright >= dark + 12 dB - the
    travel THROUGH the fan-out path is the hardware claim; the bit-exact
    sum lives in tb_prog_sources (replica = base + modenv + channel).
    Dark at the chain floor is the filter closing - success.
2026-09-10 Fix the every-32-note-ons dropout: init burst overflowed the prod queue
    Thor: every 32 note-ons the cutoff goes low. Root cause: the #44
    fan-out init added 64 producer pushes, taking the boot burst to 262
    against PROD_QUEUE_LEN 256 - the tail silently dropped, and the tail
    was voices 30/31 amp-envelope configs. Those voices played at the
    gain floor forever; LRU cycling made it periodic with NUM_VOICES.
    - PROD_QUEUE_LEN 256 -> 512 (2x headroom over the 262-push burst)
    - engine_link_drops() accessor + init tripwire: voice_alloc_init now
    SCREAMS if any engine write dropped during the boot burst
    - tools/voice_cycle_check.py: plays a full pool cycle (36 notes),
    asserts per-note level spread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
    [engine_link.c, engine_link.h, voice_alloc.c, voice_cycle_check.py]
2026-09-10 tools: modenv_uniformity_check - reproduce the stale-RATES drag bug
    [modenv_uniformity_check.py]
2026-09-10 engine_link: backpressure on producer writes - config never drops
    Thor (15:14): random notes had a LONGER MOD envelope, ~every 32nd.
    Reproduced with tools/modenv_uniformity_check.py: a two-knob drag
    (MOD decay + PW) wedges the engine task in a 256-row element flush
    (~15 ms of SPI); meanwhile coalesced applies keep pushing 96-write
    update_mod_env bursts, the prod queue overflows, and the dropped
    TAIL = the highest voices keeps RATES from earlier in the drag -
    stale = longer. Measured spread 43.3 dB across the pool.
    Fix: producer writes now BLOCK with a 50 ms bound instead of
    dropping - config must be lossless; the caller (voice_alloc task)
    already yields for the watchdog. Plus always-on drop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
    [engine_link.c]
2026-09-10 Lossless config via retry-on-drop; revert blocking prod sends
    Risk containment: the 50 ms blocking send shipped an hour ago
    coincided with a NEW symptom (reused voices playing silent after a
    CC storm) - reverted pending diagnosis. The lossless guarantee moves
    up a level: apply_dirty snapshots engine_link_drops() around each
    config burst and re-arms the same dirty bits if anything dropped, so
    the coalescer retries the whole batch at its bounded pace until it
    lands complete. No blocking, no starvation risk, config eventually
    consistent by construction.
    [engine_link.c, voice_alloc.c]
2026-09-10 Day close-out: policies, test-rig documentation, staleness sweep
    Thor 2026-09-10 policies into AGENTS.md standing rules: all ongoing
    work tracked on GitHub with checkboxes ticked as finished; regular
    stale-ticket sweeps; untested new features are never completed
    (sim + hardware + real use before closing); every FPGA load requires
    an ESP32 reboot. New AGENTS Test-rig section documents the dev
    machine + prototype wiring end to end (three MIDI ingresses, USB
    serial topology, panel server, capture chain).
    Staleness sweep across every .md: README gains the GPIO2 panel-MIDI
    row and the current slider-calibration keys; design.md retires the
    combiner-on-demand line (built as bus-as-source #44); mid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
2026-09-11 CC 28 stereo spread goes continuous; #98 comment corrections
    Thor asked why Uni Stereo was not a knob: because the firmware only
    read CC 28 as a bool (>0 = hard pan) despite the schema calling it a
    SPREAD. Now continuous: plan.l/r mark which side a unison element
    leans; spread 0 = centered, far side attenuated 0.375 dB/step, 127 =
    exact far-side mute = the historical hard pan bit-for-bit (default,
    so the boot sound is unchanged). Panel knob restored.
    element_pipeline comment fixes from #98: the GATE word never becomes
    an ADSR trigger (envelopes are walker sources watching gate BUSES;
    GATE is the exact-mute path, and Thor proposes dropping it); the #84
    wording no longer says same-bus source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
    [element_pipeline.sv, patch.c, voice_alloc.c]
2026-09-11 element_pipeline: envelopes are gated by a control input, not watching
    Thor #98: direction was inverted - the bus captures the envelope
    output; the ADSR reads its gate bus as a CONTROL input (the FET
    gate terminal, completing source/drain/gate).
    [element_pipeline.sv]
2026-09-11 docs: blessed vocabulary - send, source/sink/gate triad, node graph
    Thor 2026-09-11 (#98): type 3 is the SEND (mixing-console aux send,
    the fabric first PROCESSOR vs the generators LFO/ADSR); the FET
    analogy completes as source / sink (drain) / gate, making the ADSR a
    gated generator; and the fabric is admitted to be what it is - a DAG
    evaluated in table order, buses as junction nodes. Settles #50
    rename targets: source_table, types {lfo, adsr, send}.
2026-09-11 Bus-sum RAM: sends read the OUTPUT SUM; LFO2 gains a CUTOFF dest (#92/#98)
    Thor: the intention of a send is to reference the output sum of a
    bus, and bus-sum comes first. bus_sum_ram is a walker-facing mirror
    written by the same strobes as the six replicas; a SEND reads it at
    P1 (own RAM, own register, selected by type at P2) - firmware base
    plus every contribution written so far, same-sample for sources
    ordered before their sends. The node graph edges are now real.
    Bench: LFO tremolo -> bus 6 -> unity send -> gain bus 3 asserts the
    walker contribution propagates through the send (the property the
    firmware-base read could not provide); existing send cases unchanged
    (sum mirrors base when on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
2026-09-11 bus_architecture: half-rate walker approved (Thor, 2026-09-11)
    Alternate table halves per sample - 48 kHz effective per source;
    zipper at 24 kHz, inaudible past the master tilt. Budget doubles to
    ~320 entries; pool grows to 256 with the per-osc graph rung.
2026-09-11 Engine no-op write elision; Big-O/lazy principle into AGENTS
    Thor 2026-09-11: aim for Big-O efficiency and lazy loading across the
    code base. First application where it bites hardest: the engine drain
    now skips writes whose value already matches the reference image (the
    FPGA-reload -> ESP-reboot rule is what makes image-equality mean
    FPGA-equality). A one-knob D_RENDER re-render previously dirtied all
    ~1800 element words and burst all 256 rows (~15 ms of SPI - the wedge
    pressuring #97); now only genuinely changed words dirty, touched rows
    flush. Same elision on the producer image.
    [engine_link.c]
2026-09-11 Half-rate walker: 256-source pool, 48 kHz effective per source (#100)
    The walker walks 128 entries per sample - ONE HALF of the doubled
    table, halves alternating - so every source updates at 48 kHz
    effective (Thor: zipper at 24 kHz, inaudible past the master tilt).
    Frees the entry budget for the per-osc bus graph (#100) and the full
    mod matrix (#92).
    Gateware: walker_half bit + walker_index {half, entry}; table RAM
    2048x36, state RAM 256x28 (scale from NUM_PRODUCERS=256);
    producer_write_addr widened to 10 bits through spi_bus/top/benches
    (prod window now 0x0100..0x04FF, inside the backed window).
    Firmware compensations so nothing audible changes: patch_adsr_word
    bakes +0x10 into A/D/R rate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
2026-09-11 shakedown_check: restore key track to 64 (100% on the 0-200% scale)
2026-09-11 48 kHz test S/PDIF on pin 86: the LED-TOSLINK capture path (#101)
    Second spdif_tx instance clocked by new half-rate drum ticks
    (sample every 1536 sysclk, cell every 12 - same counters, same
    reset, so the frame boundary sits on the cell grid by construction).
    Audio is the main mix decimated by 2 with pair averaging; the
    2-tap boxcar's null lands at 48 kHz and the 2 kHz master tilt has
    already crushed everything near the new Nyquist.
    spdif_tx gains a CS_FREQ parameter (channel-status byte 3): the
    module was already rate-agnostic - the stream follows the ticks -
    but the status block must DECLARE the rate, and the old constant
    would have told the receiver 96 kHz. Default 0x0A keeps the main
    ins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
    [drum.sv, spdif_tx.sv, tb_spdif48_block.sv, top.sv]
2026-09-11 spdif48_first_light: LED-TOSLINK path verification tool (#101)
    Proves the digital capture path end to end: flips the CM106 capture
    source Line -> IEC958, enables the CC 119 purity tone over BLE,
    captures, and checks the 1500 Hz line lands exactly on bin 32 of a
    1024-point FFT at 48 kHz; then captures tone-off silence. A
    --lock-probe mode polls with short captures and no Bluetooth (the
    CM106 aborts reads with I/O error when its receiver has no lock, so
    data arriving IS the lock proof) - meant to run while the LED is
    physically adjusted.
    First hardware run (2026-09-11, LED taped into the ICUSBAUDIO7D
    optical input): PASS. Tone -0.0 dBFS on bin 32, harmonics at the
    16-bit floor (-110 dBc), off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
    [spdif48_first_light.py]
2026-09-11 48 kHz S/PDIF on pin 27 is the primary audio path (#101, Thor)
    Thor ratified the bring-up wiring as the permanent arrangement: pin
    27 (the original S/PDIF pin) carries the 48 kHz stream and fans out
    to BOTH sinks on the veroboard - the coax through the consumer-level
    divider to the Focusrite for human listening, and the 68 ohm + red
    LED taped into the ICUSBAUDIO7D optical input for bit-perfect
    automated capture. The 96 kHz stream parks on header pin 86, unwired
    (#53 remains the future high-rate instrument).
    - constraints.cst: pin swap committed (48 kHz -> 27 DRIVE=16, 96 kHz
    -> 86), with the veroboard fan-out documented at the assignment.
    - top.sv: header + section comments follow.
    - spdi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
    [spdif48_first_light.py, top.sv]
2026-09-11 design: decimator upgrade note - engine stays 96 kHz internally
    Thor, 2026-09-11: only the pin-27 output tap decimates; the engine
    runs 96 kHz throughout. Pair averaging is the first cut; a
    windowed-sinc / Lanczos polyphase decimator is the acknowledged
    upgrade, gated on the listening verdict.
2026-09-11 mash_check: chaos-in-silence-out standing regression (#97, Thor)
    Live incident 2026-09-11 ~16:23: after heavy keyboard mashing with
    all keys released, a flat -32.6 dBFS drone persisted indefinitely -
    RMS dead constant for 30 s (a stuck gate, not a long release), lines
    at D4+D3 (a stuck voice wearing the default patch's -12 sine sub)
    plus a low ~50/117 Hz cluster (Thor: "a diesel boat driving across a
    lake"). Captured bit-perfect over the new digital path, published as
    stuck-drone-97-20260911-171346.flac on the audio-captures release.
    New standing test (Thor: "After any change to the synth, run this
    mash test"): tools/mash_check.py - resets BOTH boards (SRAM reload
    then ESP reboot, the stand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
    [mash_check.py]
2026-09-11 mash_check: AC-silence criterion - tolerate the #102 parked DC
    First run (seed 6938) was a double result: NO stuck voices (clean
    decay 13 s after the note-offs - the #97 wedge did not reproduce),
    but the strict bit-exact-zero bar tripped on a constant -90.3 dBFS
    with every sample nonzero and zero spectral content: the output
    tilt's truncating integrator parks a ~1-LSB DC after signal decays
    (filed as #102, error-feedback fix direction).
    PASS is now AC-silence: zero samples deviating from each channel's
    median, with that median within 4 LSB of zero. A stuck voice still
    fails loudly; a parked DC no longer blocks the standing regression.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
    [mash_check.py]
2026-09-12 Boot self-test: probe address off the live bus pool (#103)
    The out-of-window probe wrote 0xBAD0BAD0 to 0x0805 - outside the
    backed store (so the test passed) but INSIDE the bus pool
    (0x0800-0x0BFF), so every boot fired the bus mailbox and parked bus 5
    at a large negative base. A self-test moving a live fader, silently.
    New probe address 0x1005: decodes to nothing (misses backed, bus,
    producer and element windows) AND still aliases 0x0005 under the
    11-bit mask, preserving the alias-detection semantics that 0x0805 had
    (the review's suggested 0x0FFF would have aliased 0x07FF instead and
    weakened the check). Window inventory documented at the call site.
    Also #110: the boot banner's "gate-by-ga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
2026-09-12 Output tilt: error feedback, extracted to output_tilt.sv (#102)
    The master tilt's truncating one-pole (out += (in-out)>>>3) parked at
    a small nonzero residual on silence - updates below 2^3 truncated to
    nothing, measured on the digital path as a constant ~1-LSB16 DC.
    First-order error feedback: keep the truncated remainder, add it back
    next sample. The accumulated step becomes exact, so the integrator
    converges to EXACT zero on silence and the exact input value on DC;
    the passband is untouched (the reshaped quantization error is
    ~1 LSB24). Extracted to its own module (two instances in top.sv) so
    it can carry a bench: new tb_tilt asserts exact-value convergence and
    a held exact zero from bot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
    [output_tilt.sv, tb_tilt.sv, top.sv]
2026-09-12 Review fixes: corrupted ADSR names, swapped S/R comment, stale docs (#104, #105, #110)
    - element_pipeline.sv: the 2026-09-01 rename left three ADSR
    identifiers as gibberish (adswap_toggle_prevecay_step and friends,
    #104) - renamed to adsr_decay_step / adsr_sustain_target /
    adsr_stage_prev, all 10 occurrences, zero behavior. Header format
    table, s9_elem and the mix accumulator now say Q4.14 (#63 repoint;
    the Q2.16 labels on the state-conversion shifts are left alone -
    they describe era-fixed arithmetic, not the transport format).
    - synth_pkg.sv: the RATES comment had sustain and release swapped
    vs the decode, patch_adsr_word() and memory_map.md (#105).
    - memory_map.md: OSC row n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
    [element_pipeline.sv, engine_link.c, synth_pkg.sv, voice_alloc.c]
2026-09-12 spi_regs.c: honest header - live transport vs byte-protocol reference (#109)
    Header now says which half is live (fpga_spi_init, the SPI transport
    everything rides) and which is the legacy byte-protocol reference
    kept for A/B link debugging with spi_slave_regs.sv. (The orphan
    i2s_rx.sv deletion for the same issue rode the previous commit by
    staging order.)
    [spi_regs.c]
2026-09-12 docs: AUTHORS.md provenance ledger; first commit as @noaidi-claude (#99)
    Establishes the author map the historical record cannot carry:
    two humans (Thor @Thorwegian, Jens @jenstf) and two agents (Claude
    @noaidi-claude, Hermes pending). Documents what is and isn't
    correctable - issue/comment authorship is fixed by GitHub, commit
    authorship is identifiable via the Co-Authored-By: Claude trailer,
    and history rewrite is declined (dense SHA citations in the tracker).
    This is also the first commit authored under the @noaidi-claude
    machine identity (repo-local git author = its GitHub noreply
    address; Thor's global git identity untouched). Going forward,
    Claude's gh traffic and commits carry this i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
2026-09-12 docs: AUTHORS.md - Hermes now @HermesOracle (#99)
    Hermes has its own machine account (verified collaborator, HTTPS push,
    commits attributed). Ledger row filled in, no longer pending.
2026-09-12 tb_osc_core: emit the ALL PASS marker CI greps for (#107)
    sim-osc joined the CI matrix in this PR and immediately failed - not a
    real regression: the bench printed "RESULT tb_osc_core: PASS", which
    ci_bench.sh does not recognize (it requires "ALL PASS" or "PASS:").
    Aligned to the suite-wide marker; the test itself was passing.
    [tb_osc_core.sv]
2026-09-13 tools: chord/mono cutoff-glitch repro for #97
    Two tools that objectively reproduce and characterize the #97
    "cutoff goes low once in a while" symptom:
    - glitch_hunt.py: fixed pitch, mono, cycles the 32-voice pool,
    measures each note's spectral centroid; catches the stuck-dark
    voice (e.g. voice 23 at 244 Hz vs 1356 Hz median).
    - chord_glitch.py: Thor's real conditions - bright resonant patch,
    repeated 4-note chords; the dark voice shows as a high-band-fraction
    collapse (15-24% vs 42%) with a total-RMS rise, recurring every 8
    chords = every 32 voice allocations = one voice per pool cycle.
    [chord_glitch.py, cutoff_diag.py, glitch_hunt.py, note_path.py]
2026-09-13 Fix #97: drain the walker pipeline at the half boundary
    The producer walker bus write is pipeline-delayed one entry (entry N
    writes during entry N+1 P5). The step machine froze the instant
    walker_entry hit WALK_PER_SAMPLE, so the last real entry never had an
    N+1 to write in and its bus write dropped. Index 127 of half A is
    PROD_FANOUT(31) - voice 31 cutoff send - so BUS_CUT(31) never got the
    channel cutoff and voice 31 played dark every 32nd note (#97). The
    half-rate walker (#100) put a live fan-out at that boundary, surfacing
    it.
    Run WALK_DRAIN=2 extra entries via a registered drain counter so the
    trailing write completes. Drain entries carry producer_valid=0
    (walker_active still gates rea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
    [element_pipeline.sv]
2026-09-13 mash_check: reboot to a clean default patch when it finishes
    The mash fires ~2500 random CCs and never reset them, leaving the synth
    on a scrambled patch (random pan/balance/reso/cutoff). Playing on that
    reads as quiet/buzzy/cutting-off notes - it masqueraded as a #97
    regression on 2026-09-13 after the mandatory post-change mash. Now the
    tool reboots the ESP (no FPGA reload) at the end, PASS or FAIL, so the
    synth is always left on a clean default. AGENTS notes: never diagnose
    audio on a post-mash synth without a reboot.
    [mash_check.py]
2026-09-13 test(#117): reproduce SVF cutoff-modulation instability
    Add tb_svf_modulation.sv (standalone target `make sim-svfmod`, kept out
    of the default sim gate) that reproduces #117 deterministically.
    The Chamberlin SVF is stable under cutoff modulation at the default
    resonance (q1=1.0), but diverges to the full-scale rail once resonance
    reaches an ordinary musical setting (threshold Q~=1.4..2.0, r between
    0x400 and 0x600) and the cutoff is swept across a wide range - which
    mod-env->cutoff does in play. A smooth sweep is enough; no violent step
    (no #106 bus-race glitch) is required, so #117 and #106 are independent.
    The 4-pole default (dual=1) makes it worse, but a single pole also rails
    at high re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
    [tb_svf_modulation.sv]
2026-09-14 docs(#117/#118): record TPT migration and g/R2/h/pitch decisions
    The Chamberlin SVF is conditionally unstable (#117); migrate to the
    ZDF/TPT filter (JUCE reference). Records Thor's decisions: linear
    g = K/2 (reuse the tuned K-LUT halved, no runtime tan; accept the
    -10.7c self-oscillation pitch error at C8, inaudible up there),
    R2 = q1, h via a 16-entry-seed 2-iteration Newton reciprocal, state
    Q8.28 with full-width g in the core multiplies. See docs/svf.txt.
2026-09-14 feat(#117): ZDF/TPT SVF replaces the Chamberlin filter
    Fixes the #117 cutoff-modulation-at-resonance instability by replacing
    the conditionally-stable Chamberlin SVF with a topology-preserving-
    transform SVF (JUCE StateVariableTPTFilter form). Unconditionally
    stable: the internal filter state stays ~1.75 at r=0x800 under a
    full-range cutoff sweep where the Chamberlin diverged to the rail --
    matching the pole-radius proof and the Python fixed-point model.
    Design (see docs/svf.txt):
    - g = k>>1 (= pi*fc/fs): reuse the tuned, octave-scalable K-LUT halved,
    full-width in the core for pitch (self-osc melodies); no runtime tan.
    Linear-approx pitch error reaches -10.7c only at C8 (accepted).
    -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
    [element_pipeline.sv, svf_tpt.sv, tb_svf_modulation.sv]
2026-09-15 More Tang Nano 20 docs
    [Tang_Nano_20K_3921-Demensions.dxf]
2026-09-15 fix: park the resonance slider (spurious CC71 on the prototype board)
    The panel resonance fader (GPIO1/ADC1) fires spurious CC71 on the
    prototype board and isn't needed right now (Thor 2026-09-15). Gate its
    CC71 output behind s_slider_active=false; the poll task, ADC and console
    keys ('1'/'2'/'r' slider, 'p' BLE) stay live, so re-enabling is a
    one-line flip. Verified on hardware: firmware boots ALL OK, chords
    sound, 4 s idle shows no spurious CC71.
    [slider.c]
2026-09-16 Relevant datasheets for PCB design.
2026-09-17 #43: saturate the filter state at +-32 and temper the resonance knob
    Two coupled fixes for the top-of-dial "pure static".
    (A) gateware, svf_tpt.sv: the SVF integrator state was the one datapath
    node that WRAPPED instead of saturating. At max resonance q1 (=R2)
    underflows to 0, the resonator goes undamped, and the Q8.28 state
    diverges past the 36-bit register rail and wraps in two's complement
    -> full-scale static. Add sat_state, a hard clamp at +-32.0 on all
    four state writebacks, matching the sat24 / sat_q414 discipline used
    everywhere else in the datapath. Below the clamp (the whole clean and
    normal-resonance range) it is bit-identical to before.
    (B) firmware,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
    [svf_tpt.sv, voice_alloc.c]
2026-09-17 #43: state clamp +-32 -> +-96 (numeric headroom, not a musical ceiling)
    The +-32 from 7442120 clipped legitimate resonance: with the tempered
    knob (Q<=32) a full-scale note drives the integrator state to ~49, so
    +-32 truncated real resonant peaks (~-14 dB error in the model).
    Fixed-point sweep (36-bit intermediates, matching the RTL regs) puts the
    clean window at +-64..+-120: below ~48 clips legit resonance, and at the
    exact +-128 register rail the pole's own 36-bit intermediate sums (t,
    s1n, ...) wrap and the static returns. +-96 sits mid-window: 2x above the
    largest legitimate state (never clips), a quarter-range below the rail (no
    intermediate wrap). Saturates as near the natural registe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
    [svf_tpt.sv]
2026-09-17 #43: resonance-indexed input attenuation (Q-based LUT)
    Pre-filter attenuation so the 24 dB/oct dual cascade stops overdriving its
    internal +-8 sat_q414 guardrail at high resonance (the CC 80+ clipping).
    reso_att_lut (64 x UQ0.16, generated from the ear-approved gain_sweep_combo
    curve -- keep raw pole2 <= 5.5) scales the oscillator sample before the SVF,
    dual-gated (single never overdrives -> unity). Register-then-multiply
    (S3B/S3C) keeps the osc_core critical path intact; SVF untouched.
    Machine test: timing PASS 3/3 @ 73.73 (elem 160+, drum 75.9, i2s 136+);
    sim elem/outputs/spdif/spi/bus/prog-boot/prog-sweep PASS (rest running).
    Static LUT baseline; adaptive threshold-limiter successor is #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
    [element_pipeline.sv]
2026-09-18 #121 M1+M2: log-domain limiter core + master output deployment
    limiter.sv: per-step log-domain peak limiter, division-free. Everything
    lives in att_lut's log-gain grid (16 units/octave, 0.375 dB/unit):
    level -> log2 estimate (lzc octave + 16-entry log_lut frac) -> target =
    max(0, level_code - thresh_code) -> gain_q slews (attack/release, SUB
    sub-step bits) -> att_lut decode -> gain. State is owned by the
    instantiator (a register for the master, a RAM for the filter later);
    level and the gained signal are separate ports, so feedforward /
    feedback / sidechain is wiring, not a mode. Bit-faithful to
    scripts/limiter_model.py.
    Master deployment (S11): on the PRE-clip accumulators (attenuate befor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
2026-09-18 AGENTS.md: standing policy -- use all four dev-machine cores (make -j4)
    Thor, 2026-09-18: the 4-core Mac Mini is the only rig for this project;
    anything parallelisable runs parallel. `make -j4 sim` always (the per-bench
    log files from #58 exist for exactly this), `-j4` for compiles, and the same
    job count for any new fan-out tool. The command was already documented in
    Build & verify; it was not a standing policy, and a serial `make sim` made
    simulation read as a 25-55 min wall on 2026-09-17 when it is ~7.5 min.
2026-09-18 #121: fix the master limiter's silicon timing failure (pipeline it)
    The first cut sputtered on hardware (Thor, 2026-09-18: regn-telt.wav,
    median 50 ms RMS -63 dBFS, 25 dB window jumps, envelope modulating at
    1-12 Hz) while being CLEAN in simulation. Diagnosis by elimination --
    the bit-faithful model passes, tb_limiter passes, and a new in-situ
    bench against the shipped RTL measured peak -0.8 dBFS with 0.1 dB
    between windows. Identical RTL clean in iverilog and broken on silicon
    is the signature AGENTS.md already documents five times over: a timing
    failure STA passes and the ear catches.
    Cause: S11 phase 1 chained abs -> max -> lzc -> barrel shift -> LUT ->
    adds -> LUT -> barrel shift in ONE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
    [element_pipeline.sv, limiter.sv, tb_element_pipeline.sv, tb_limiter.sv, tb_prog_limiter.sv]
2026-09-18 Test gateware on hardware; drop iverilog as the verification gate
    Thor's call (2026-09-18) after a measured head-to-head on the same
    question, same DUT (c0604fa), machine otherwise idle:
    iverilog 429.7 s one bench (tb_prog_limiter), compile + run
    hardware 9.6 s 2.7 s SRAM load + 6.8 s capture & analyse
    The board additionally pays make pack.fs once per RTL change (416 s on
    this design), which amortises across every question asked of that
    bitstream; the second question costs 9.6 s, and so does the twentieth.
    It also answers in silicon, which is the only place the six timing
    failures on this project ever appeared -- every one of them passed STA
    and failed by ear.
    Verilator (#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
    [hil_filter_imd.py, hil_limiter_rms.py]
2026-09-18 tools: pin the IMD harness to plain mode, add the drive sweep (#125)
    Measured 2026-09-18 on main, back-to-back runs:
    plain cutoff 64 / reso 127: -12.2 -12.2 -12.3 -12.4
    unison cutoff 64 / reso 127: -7.1 -12.4 -13.4 -18.7
    7+1 unison at detune 0 buys ~10 dB of level -- tempting, because much
    of this grid sits under the -55 dBFS trust threshold -- but eight
    coherent elements sum phase-dependently on whatever the allocator
    hands out, so levels swing ~15 dB and the metric wobbles by 11 dB.
    Plain mode is the only valid stimulus; the quiet cells stay quiet, and
    that is a real limit of the metric rather than something to paper over
    with more voices. Written into the patch table so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
    [hil_drive_sweep.py, hil_filter_imd.py]
2026-09-22 #128: split the oscillator's phase adder from waveform generation
    sysclk post-route: 76.69 -> 123.17 MHz. Headroom 4.0% -> 67.1%, i.e.
    above even the 98.304 MHz clock this design ran at before it was reduced
    to 73.728.
    The critical path was one cycle carrying FIVE operation classes:
    phase_lut BSRAM read -> octave barrel shift -> 24-bit add
    -> q_idx -> sine_lut[q_idx] (a second memory read, combinational,
    indexed off the adder's own output) -> 4:1 waveform mux
    13.04 ns against a 13.56 ns period. It is the oldest path in the design
    and predates the decode-or-multiply-never-chained rule it violates.
    Two adders computed the same value: osc_core had `phase + delta`
    internally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
    [element_pipeline.sv, osc_core.sv, tb_osc_core.sv, top.sv]
2026-09-24 #134: ping-pong the bus generation, decouple the walker from the drum
    The producer walker lived inside the drum schedule for one reason: the
    six bus replicas are single-port, so walker writes and sink reads were
    kept apart BY TIMING -- the walker armed at slot 299 precisely so it
    could not collide with lane reads at slots 1..257. That spent 390 of
    768 drum slots on port arbitration rather than computation.
    Double-buffer instead. The pool shrinks 1024 -> 512, which frees
    address bit 9 to act as a generation selector while the arrays stay
    1024 deep:
    walker writes bus_ram[{~bus_gen, addr[8:0]}]
    sinks read bus_ram[{ bus_gen, addr[8:0]}]
    bus_gen toggles on sample_tick
    so the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
    [element_pipeline.sv, synth_pkg.sv, tb_prog_pingpong.sv]
2026-09-24 #134: fix two ping-pong bugs the timing numbers could not see
    Yesterday's ping-pong commit placed and routed beautifully and made no
    sound. Two distinct bugs, neither visible to Fmax, resources or the
    board:
    1. MAILBOX WRITES REACHED ONLY ONE GENERATION. The walker rewrites its
    target buses every sample, so its writes can live in one half. A
    mailbox write sets a PERSISTENT base that nothing refreshes, so a
    single-half write survived one swap and died on the next -- every
    firmware-set bus alternating with stale data at 48 kHz. Fixed by
    committing each mailbox entry over two takes, one per generation,
    latching the half written first so a sample boundary landing between
    th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
    [element_pipeline.sv, tb_prog_pingpong.sv]
2026-09-24 #134: flip the generation once per walker pass, not once per sample
    The third and last of the bugs that made the ping-pong branch silent or
    wrong, and the only one that is a genuine design interaction rather than
    a slip.
    The walker is half-rate (#100): one half of the 256-entry producer table
    per sample, so any given producer refreshes its target bus every OTHER
    sample. Flipping bus_gen every sample published a generation the walker
    had only half written, so the live half alternated between a producer's
    fresh value and its value from two samples ago. Measured as roughly
    halved LFO modulation depth, a stale link in every chain, and send
    contributions invisible.
    A generation must correspond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
    [element_pipeline.sv, tb_prog_pingpong.sv]
2026-09-24 #134: assert no swap lands inside a lane pass
    Thor's question on #134: "I hope you're not permitting a swap to occur
    in the middle of the elements pipeline's execution."
    The schedule says it cannot -- elements enter at slots 0..255 and their
    bus reads issue at S2, slots 1..256, entirely after that sample's swap
    and before the next -- but that is an argument about a schedule, not a
    measurement. Now it is a test: bus_gen must be constant across the whole
    read window, checked over eight consecutive lane passes, so every
    element of a pass provably saw one generation.
    tb_prog_pingpong now carries nine invariants, all passing:
    generation cadence, mailbox write-through, shadow write, atomic swap,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
    [tb_prog_pingpong.sv]
2026-09-24 #136 stage 1: lift the bus/source engine into bus_engine.sv
    Pure move plus a port list. No renaming, no logic change -- stage 2
    does producer_* -> source_* separately so a failure stays attributable.
    element_pipeline.sv 1474 -> 980 lines; 507 move out. The engine turned
    out to be contiguous: the six replicas plus bus_base and bus_sum_ram,
    the SPI mailbox, the ping-pong generation bit, the source table and
    state RAMs, the walker FSM, the LFO and ADSR step, and the chain
    arithmetic.
    It needs only clk, rst_n, sample_tick, sclk, the two bank bits and the
    SPI write signals -- and it references the drum's slot counter NOWHERE
    in logic, only in prose. The module boundary falls exactly where the
    c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
    [element_pipeline.sv]
2026-09-24 #136 stage 2: Control Signal Processor vocabulary
    Thor's call: analog synths call them Control Voltages; in the digital
    domain they are Signals, as in Digital Signal Processor. The engine is
    a small Harvard machine -- instruction memory, data memory, a program
    counter -- so it gets ISA and DSP terminology.
    producer_table_ram -> imem walker_entry -> pc
    producer_state_ram -> istate walker_step -> phase
    producer_type_a -> opcode_a walker_half -> pc_half
    producer_index_a -> pc_a walker_bus_* -> dmem_w*
    producer_valid_* -> instr_valid_* walker_write_* -> wb_*
    mod_source_value -> operand walker_addend -> accum_in
    de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
2026-09-24 #136 stage 3: there are no buses inside the CSP
    Thor: 'There are no buses in the control signal processor. Opcodes are
    opcodes. Instructions are instructions. Data is data.' He is right, and
    holding both vocabularies in one module is exactly the double meaning
    that produced the wrong rename earlier.
    bus_ram_* -> dmem_* six read ports into data memory
    bus_sum_ram -> dmem_local the CSP's own read port
    bus_base -> dmem_init the INITIAL image, per Thor's framing
    bus_gen -> dmem_gen
    NUM_BUSES -> DMEM_WORDS
    bus_write_* -> dmem_wr_*
    bus_mailbox_* -> dmem_mbox_*
    dest_bus_* -> dest_addr_* they are addresses, not buses
    s2_bus_* -> s2_dm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
    [csp.sv, element_pipeline.sv, spi_bus.sv, synth_pkg.sv, tb_csp.sv, tb_element_pipeline.sv, tb_prog_pingpong.sv, tb_prog_sources.sv]
2026-09-24 #136: docs describe what this actually is, and two errors fixed
    bus_architecture.md was written end to end as a bus fabric. The five
    laws are still correct as RULES -- they were stated about the wrong
    object -- so this reframes rather than search-and-replaces.
    title -> The Control Signal Processor
    new 'What this actually is': the processor mapping, the Harvard
    claim, and where the analogy stops (no control flow; two
    opcodes carry state, so instructions are not pure)
    model buses -> data memory, producers -> instructions
    laws 1,2,3,5 restated about instructions and data memory
    TWO FACTUAL ERRORS, both found by reading the RTL for Thor's req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
2026-09-25 #138: MULTADDALU18X18 probe -- and the finding that nextpnr does not time DSPs
    The primitive places on the real device (1 of 24 MAC macros) and has a
    Gowin simulation model for gw2a, so the RISC MAC is structurally fine.
    But the Fmax it reports is worthless. Control experiment: a plain
    inferred MULT18X18 in a bare register-multiply-register path reports
    1154.73 MHz. An 18x18 multiply does not run at 1.15 GHz on a GW2A --
    nextpnr places DSP blocks and routes to their pins without timing what
    happens inside them.
    Which is consistent with 39f3b02, where a real silicon crackle was
    traced to chained adder/multiply paths the tool had reported as passing.
    Our adds-only-or-multiply-only rule is em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
    [dsp_probe.sv]
2026-09-26 #138 landing 1: the CSP retires one instruction per cycle
    The 3-cycle instruction was never a pipeline problem -- the stages already
    overlapped across entries. It was memory ports. imem served CFG, RATES and
    DEPTH through ONE port with the address muxed by phase, and dmem_init served
    the gate read and the target-base read the same way. Three words through one
    port costs three cycles however the logic is arranged.
    So: imem becomes three parallel RAMs read with one address, and the init
    image gets a second copy so the gate and the base arrive together. Same total
    bits. The SPI write path is unchanged -- imem_write_addr is still
    {entry[7:0], word[1:0]} and the low bits now pick which RAM the w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
    [csp.sv, tb_csp.sv, tb_prog_pingpong.sv]
2026-09-26 #138: docs describe full rate, not the half rate it replaced
    memory_map.md's imem section and bus_architecture.md's producer-pool
    section both described the #100 half-rate walker as current. It is not:
    one instruction per cycle means all 256 entries run every sample at
    96 kHz, and the allocator rule that a chain had to live inside one half
    is retired.
    Thor's half-rate approval stays on the record, marked superseded, with
    his reasoning intact -- git holds the history but the docs should state
    what the gateware currently does.
    Also corrected the ADSR level format in both files: UQ22.5 with steps in
    1/32-LSB units, widened from UQ22.4 when the pass rate doubled so that
    envelope times did not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
2026-09-26 #145 landing 2: the opcode is a bitmask of enables, not an enum
    bit 0 reads a source operand bit 2 multiplies by DEPTH
    bit 1 has persistent state bit 3 accumulates onto the target
    No fifth bit is needed to tell an oscillator from an envelope, which is
    what I expected to need. The envelope is precisely the instruction that
    WATCHES A GATE, so state+source means envelope and state alone means
    phase accumulator. The opcode therefore still fits CFG[3:0] and no field
    moves: off 0x0, LFO 0xE, ADSR 0xF, SEND 0xD.
    Every stage now switches on decoded enables rather than on the opcode
    value, so LFO/ADSR/SEND are combinations instead of cases and a new
    instruction is an encoding ra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
    [csp.sv, synth_pkg.sv]
